nagar2021/mainet-mega/images/riel-din-arduino-mega/7150y-KmxNL._SL1500_.jpg

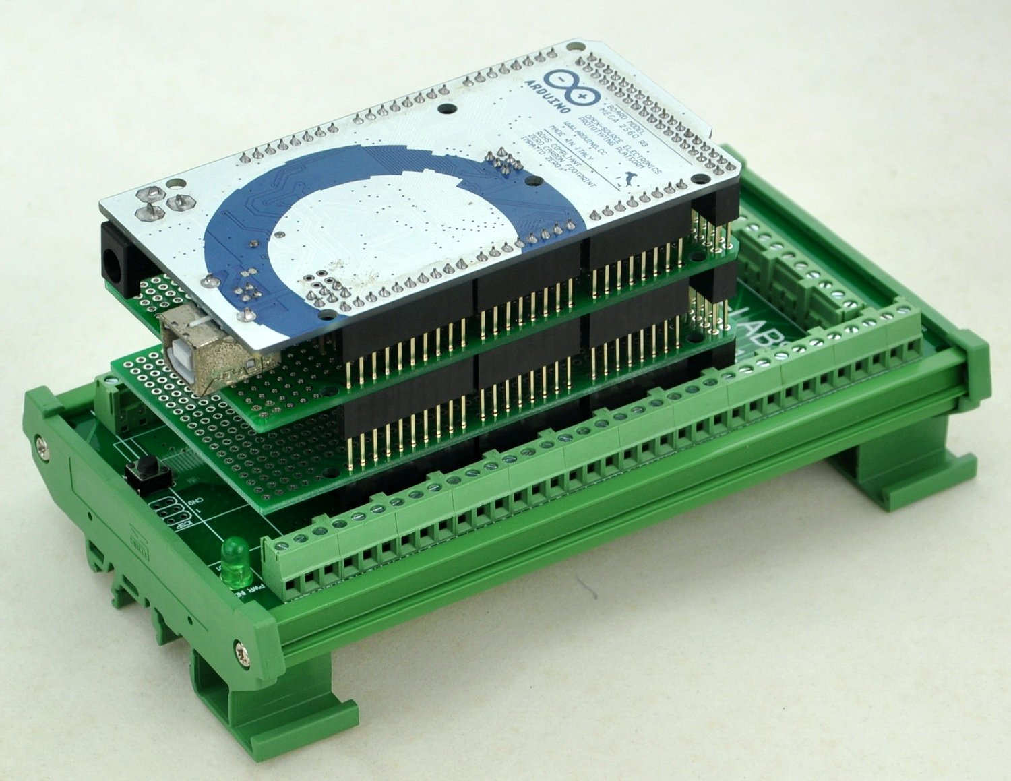
images/riel-din-arduino-mega/7150y-KmxNL._SL1500_.jpg
