nagar2021/mainet-mega/images/riel-din-arduino-mega/81a7k8UcqBL._SL1500_.jpg

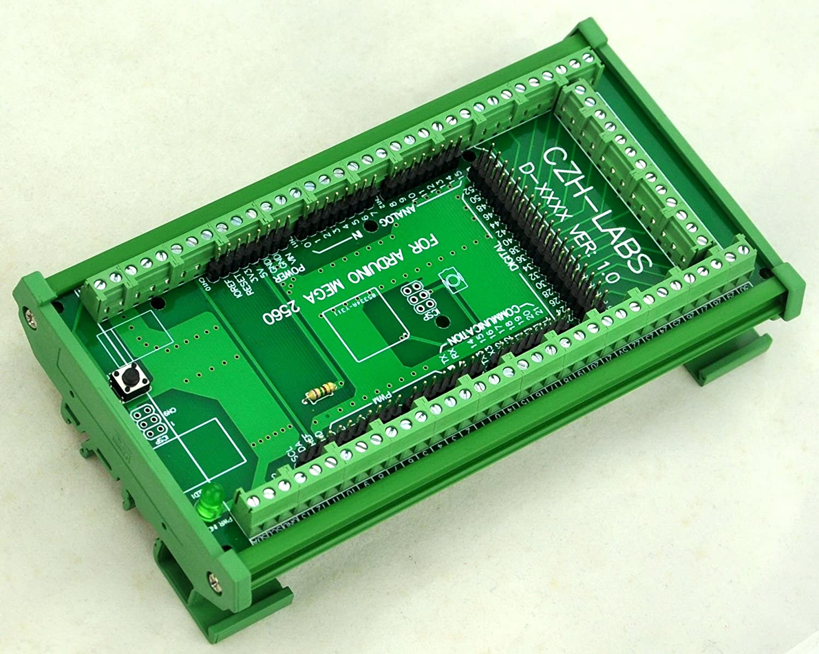
images/riel-din-arduino-mega/81a7k8UcqBL._SL1500_.jpg
