nagar2021/mainet-mega/kicad/pdf/pdf-f-silks/mainet-mega-5V-to-mp-10V--f-silk.pdf

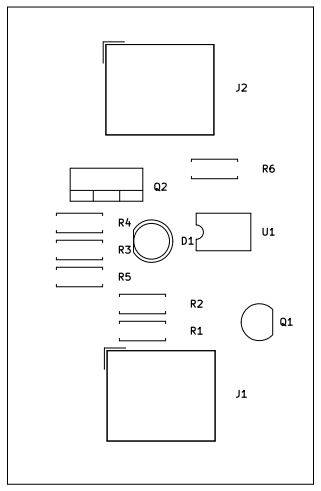
[picture p4: figure]
