nagar2021/mainet-mega/kicad/pdf/pdf-f-silks/mainet-mega-rotary-pulse-f-silk.pdf

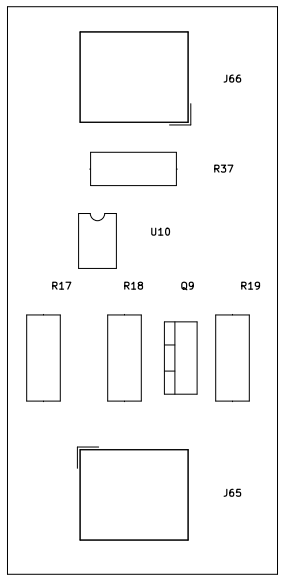
[picture p5: figure]
