nagar2021/mainet-mega/kicad/pdf/pdf-f-silks/mainet-mega-rotary-pulse-f-silk-rotado.pdf

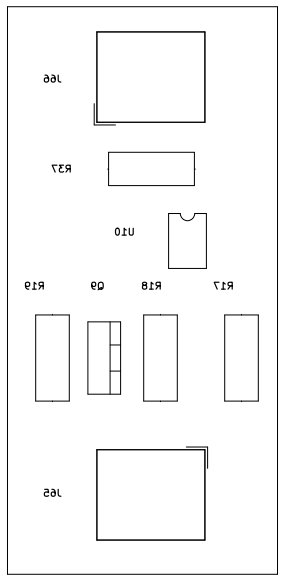
[picture p6: figure]
