nagar2021/mainet-mega/images/riel-din-arduino-mega/71Mlf5Aa4VL._SL1000_.jpg

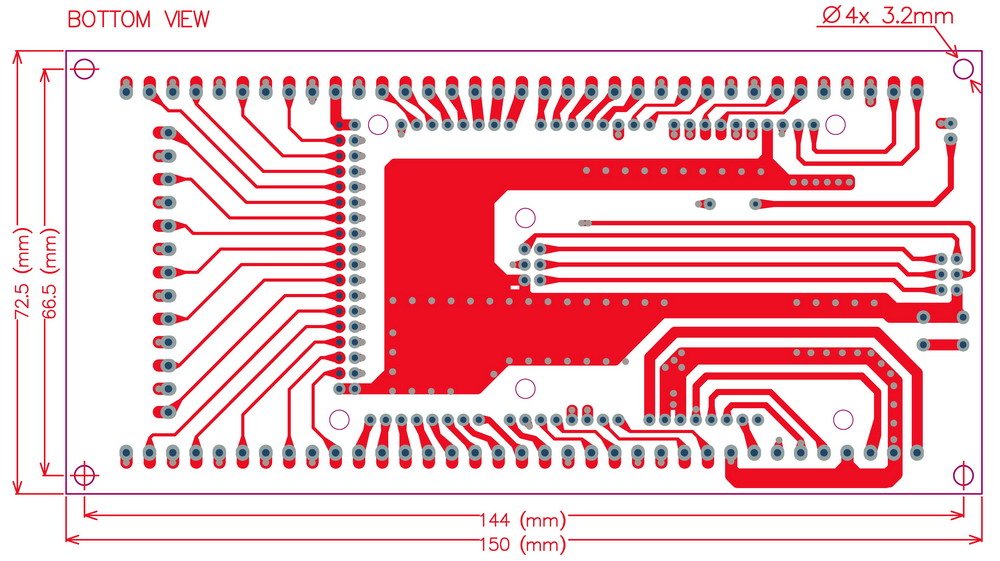
images/riel-din-arduino-mega/71Mlf5Aa4VL._SL1000_.jpg
