nagar2021/mainet-mega/images/riel-din-arduino-mega/71pCASC1ScL._SL1000_.jpg

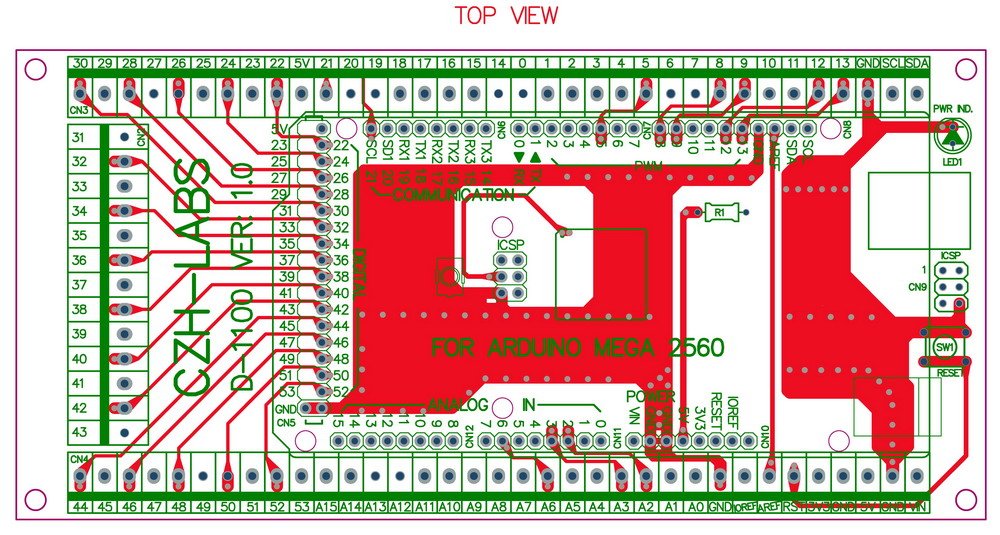
images/riel-din-arduino-mega/71pCASC1ScL._SL1000_.jpg
