nagar2021/mainet-mega/images/riel-din-arduino-mega/71uOyWxhpAL._SL1000_.jpg

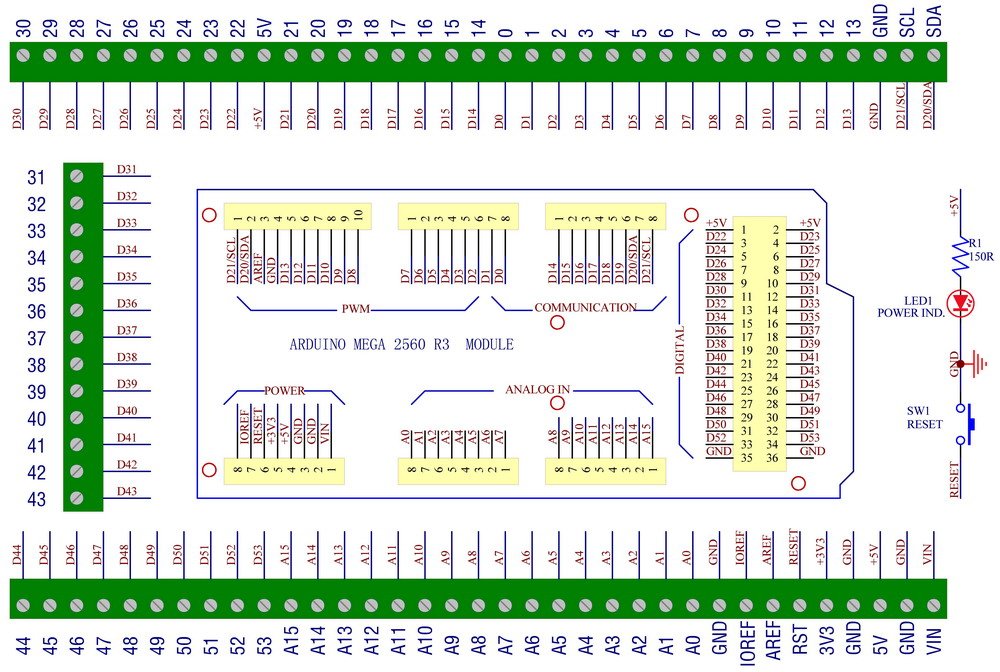
images/riel-din-arduino-mega/71uOyWxhpAL._SL1000_.jpg
