nagar2021/mainet-mega/images/riel-din-arduino-mega/81E+vQqowOL._SL1500_.jpg

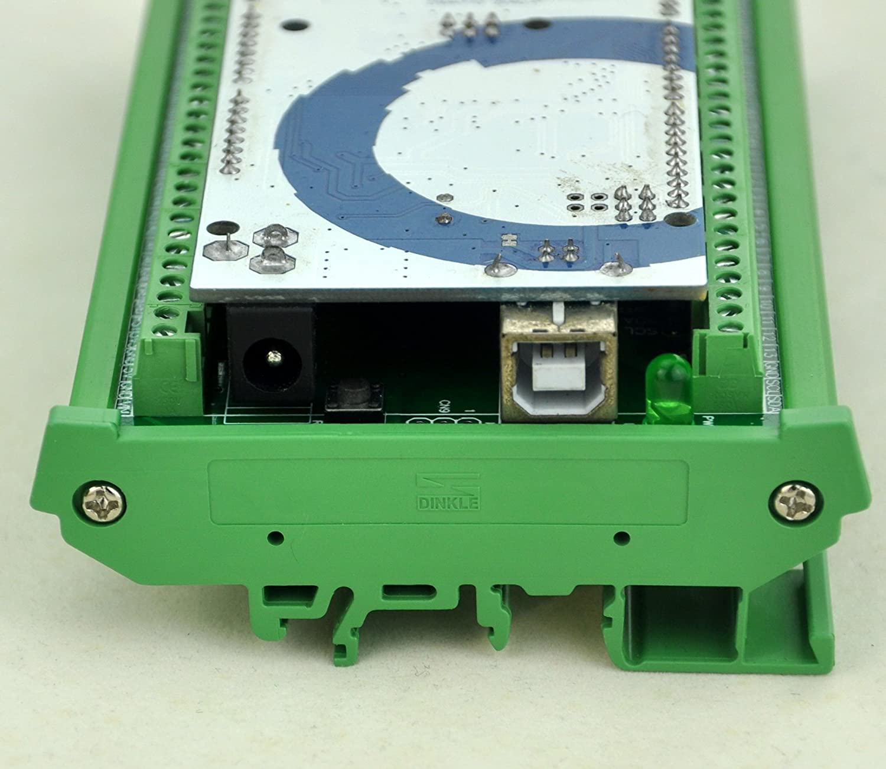
images/riel-din-arduino-mega/81E+vQqowOL._SL1500_.jpg
