nagar2021/mainet-mega/images/riel-din-arduino-mega/81m-dRdARRL._SL1500_.jpg

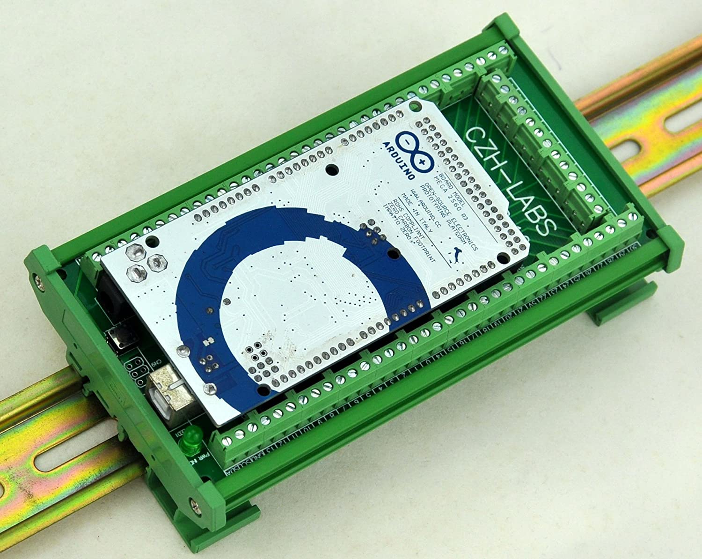
images/riel-din-arduino-mega/81m-dRdARRL._SL1500_.jpg
