nagar2021/mainet-mega/images/riel-din-arduino-mega/81qH8a+Z31L._SL1500_.jpg

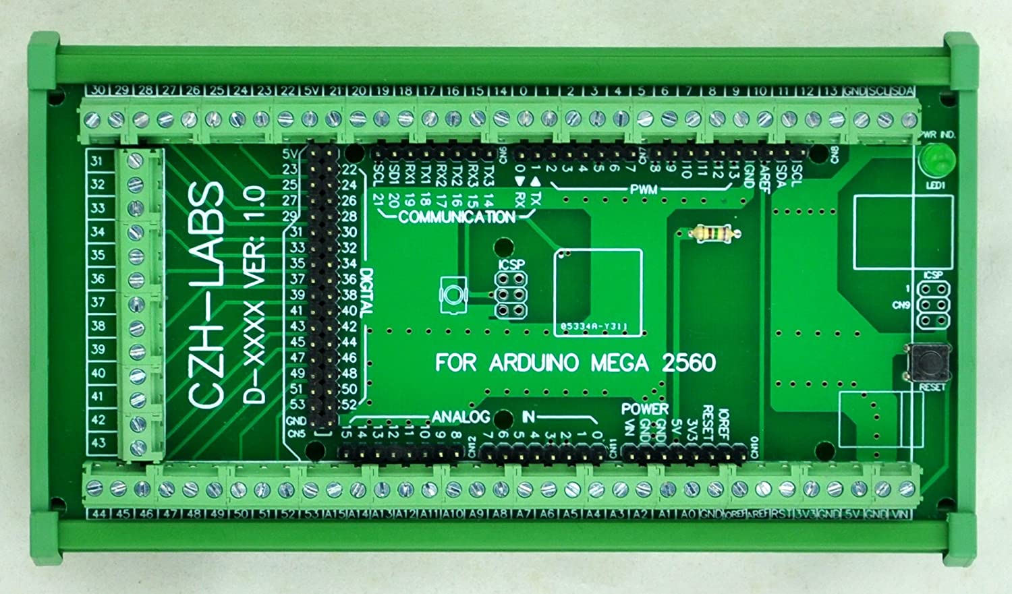
images/riel-din-arduino-mega/81qH8a+Z31L._SL1500_.jpg
