nagar2021/mainet-mega/images/riel-din-arduino-mega/8114kty3iFL._SL1500_.jpg

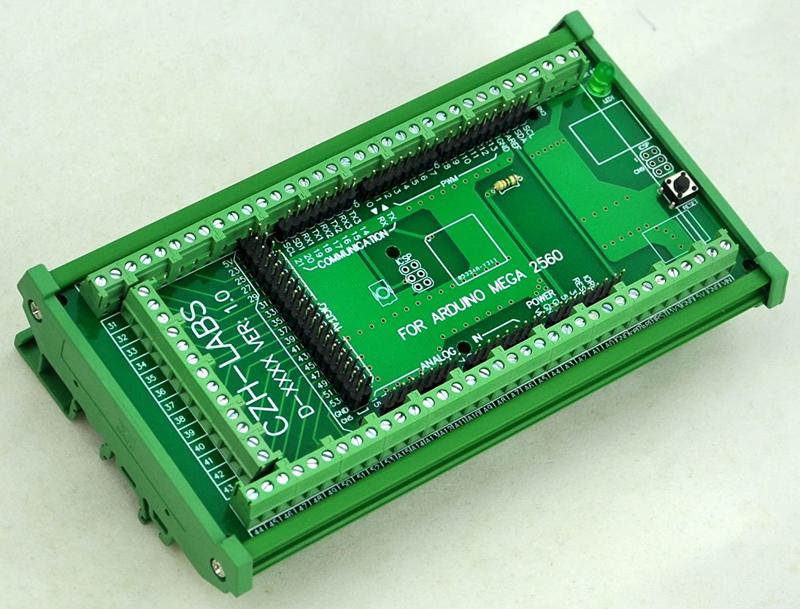
images/riel-din-arduino-mega/8114kty3iFL._SL1500_.jpg
