nagar2021/mainet-mega/images/rpg/RPG-equivalent-circuit.jpg

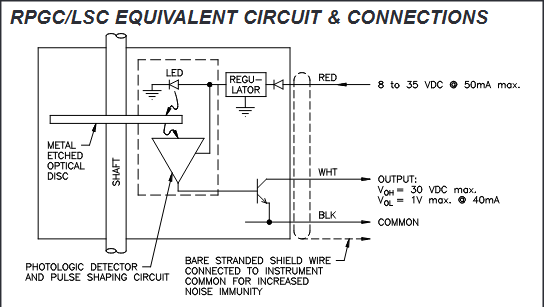
images/rpg/RPG-equivalent-circuit.jpg
