nagar2021/mainet-mega/images/rpg/RPG-frequency-output.jpg

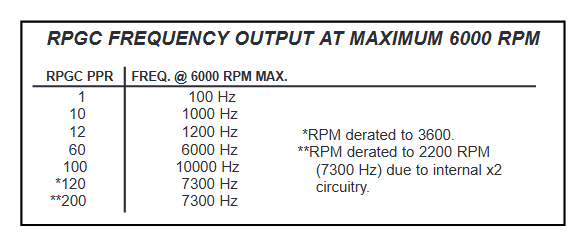
images/rpg/RPG-frequency-output.jpg
