nagar2021/mainet-mega/images/rpg/RPG-square-wave-output.jpg

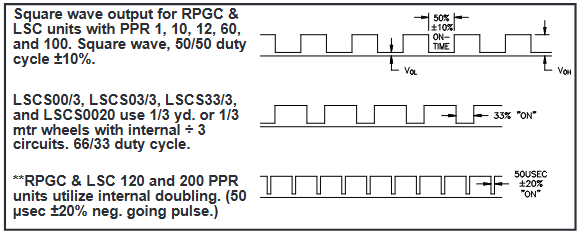
images/rpg/RPG-square-wave-output.jpg
