nagar2021/mainet-mega/images/yynmos-4/yynmos-4.jpg

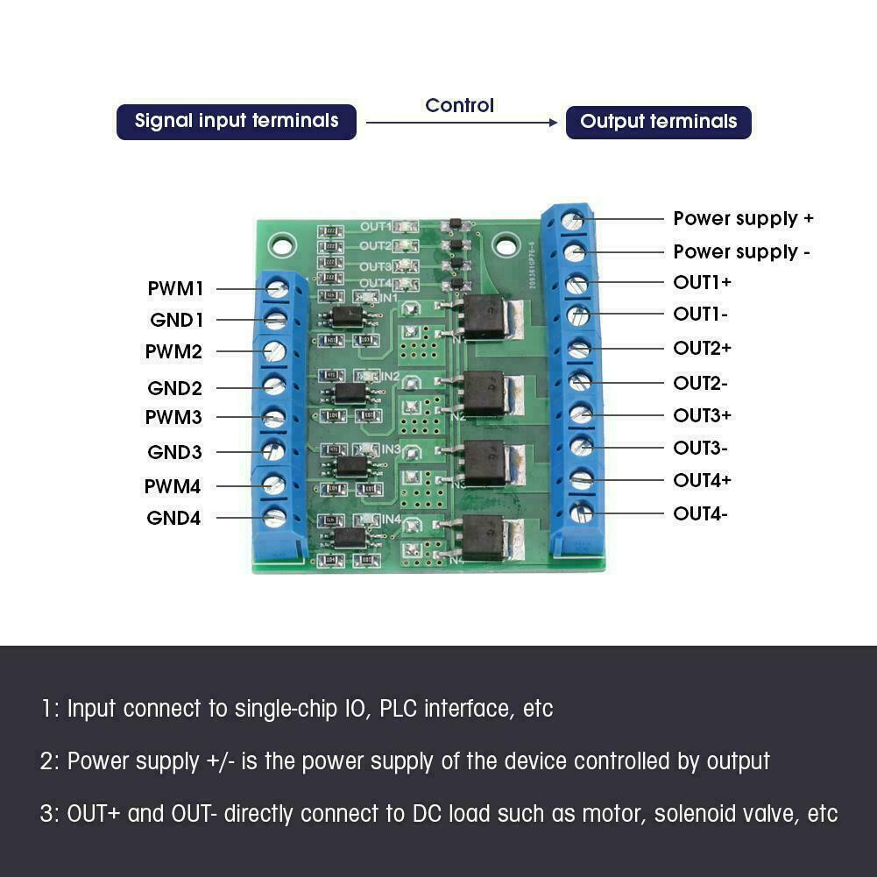
images/yynmos-4/yynmos-4.jpg
