nagar2021/mainet-mega/kicad/pdf/frequencyRefControl-mainet-mega-pwm-frequencyRefControl.pdf

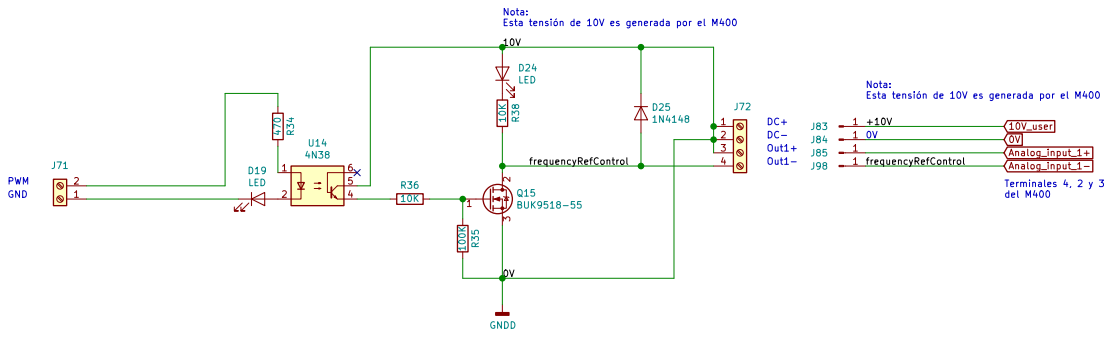
[picture p18: page 1]

0V Nota: Esta tensión de 10V es generada por el M400 GND

frequencyRefControl Nota: Esta tensión de 10V es generada por el M400

Sheet: /mainet-mega-pwm/frequencyRefControl/ Tovenca

File: frequencyRefControl.sch
Id: 18/22 Title: Mainet-mega -- frequencyRefControl
