nagar2021/mainet-mega/kicad/pdf/brakeUnwindControl-mainet-mega-pwm-brakeUnwindControl.pdf

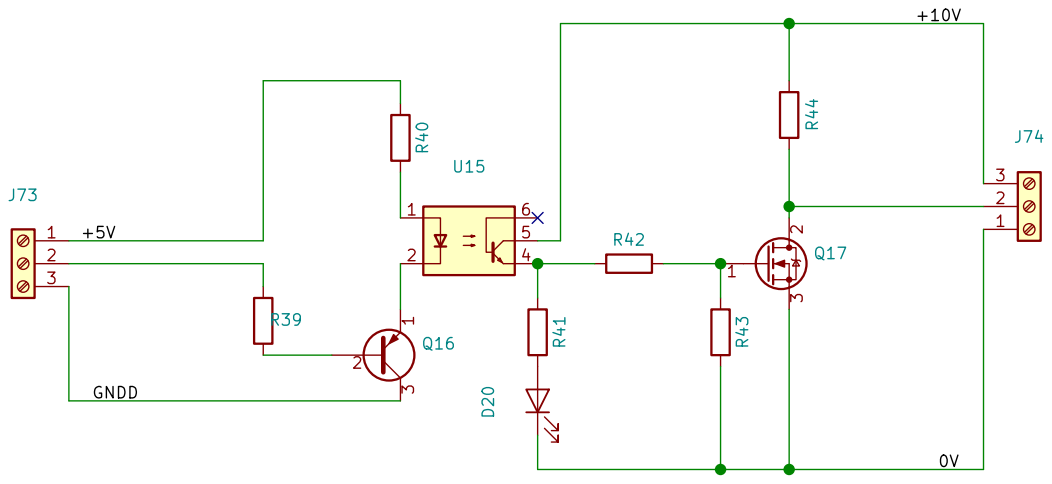
[picture p19: page 1]

Id: 19/21 Title: Mainet-mega -- brakeUnwindControl File: brakeUnwindControl.sch Sheet: /mainet-mega-pwm/brakeUnwindControl/ Tovenca R41
