nagar2021/mainet-mega/kicad/pdf/lowerClutchControl-mainet-mega-pwm-lowerClutchControl.pdf

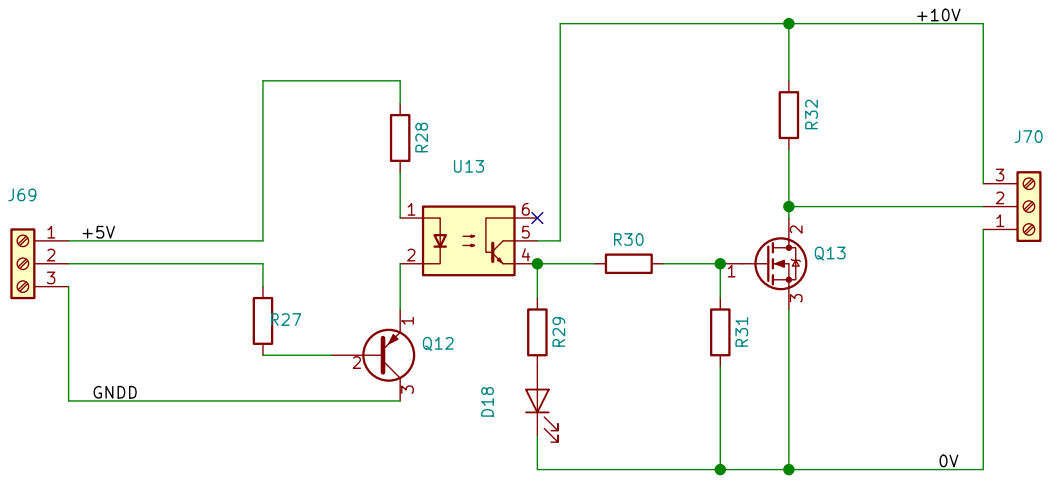
[picture p20: page 1]

Id: 17/21 Title: Mainet-mega -- lowerClutchControl File: lowerClutchControl.sch Sheet: /mainet-mega-pwm/lowerClutchControl/ Tovenca R29
