nagar2021/mainet-mega/kicad/pdf/mainet-mega-control-relay-mainet-mega-control-relay.pdf

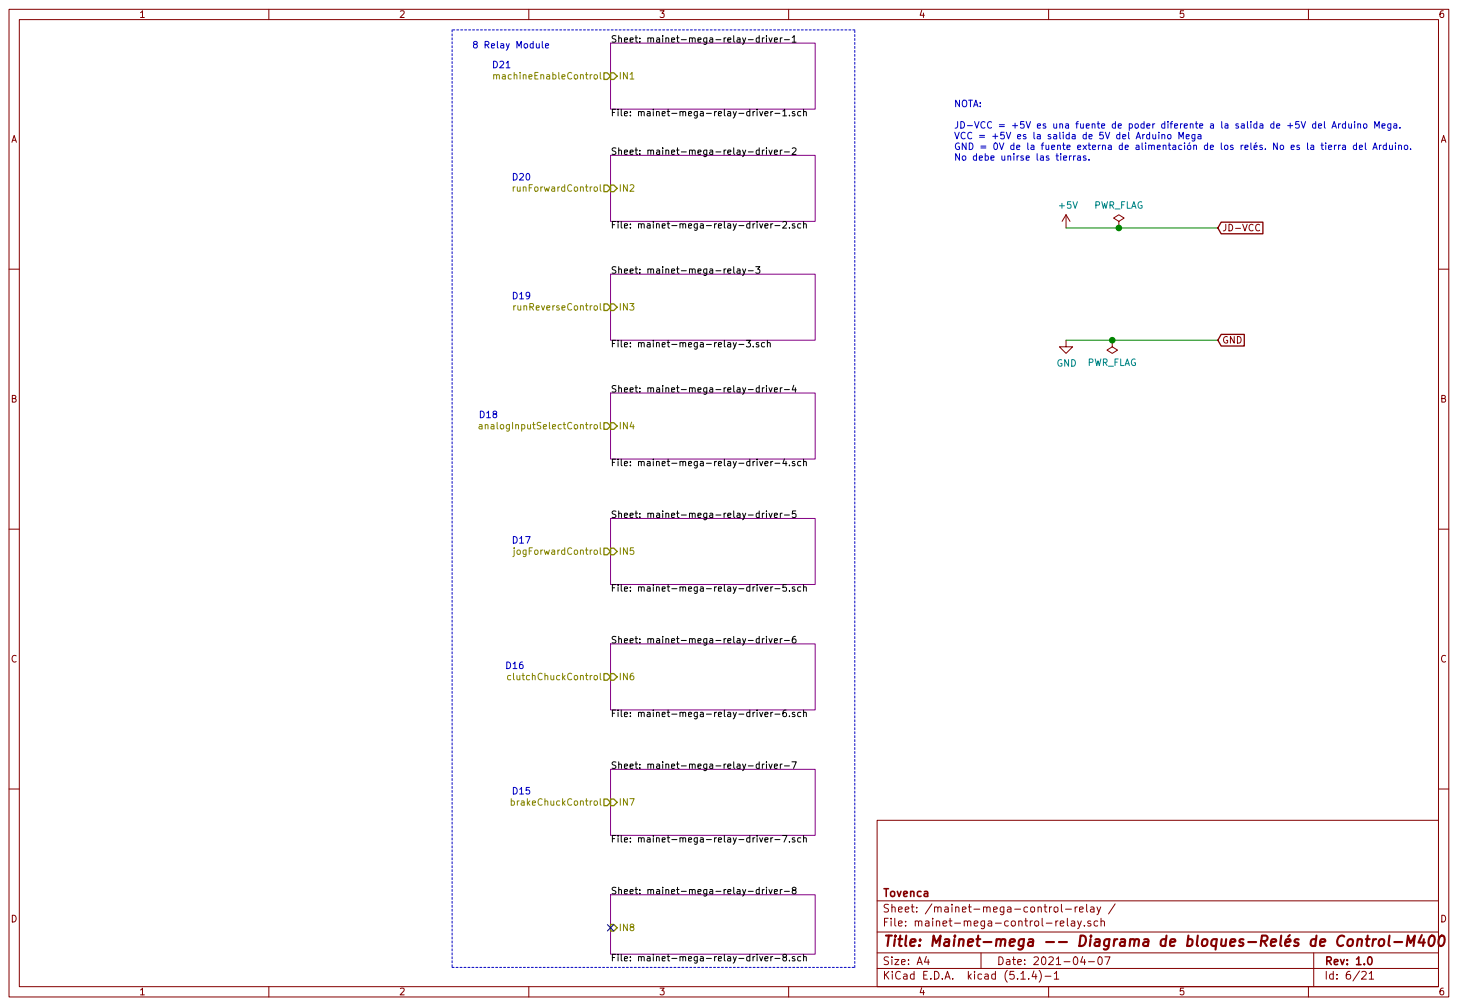
[picture p21: page 1]

Sheet: mainet-mega-relay-driver-1
runForwardControl analogInputSelectControl machineEnableControl runReverseControl

VCC = +5V es la salida de 5V del Arduino Mega GND = 0V de la fuente externa de alimentación de los relés. No es la tierra del Arduino. No debe unirse las tierras. 8 Relay Module D16

File: mainet-mega-relay-driver-1.sch

NOTA: JD-VCC = +5V es una fuente de poder diferente a la salida de +5V del Arduino Mega.

Sheet: mainet-mega-relay-driver-2

IN2 Sheet: mainet-mega-relay-3

File: mainet-mega-relay-driver-2.sch

IN3 Sheet: mainet-mega-relay-driver-4

File: mainet-mega-relay-3.sch

IN4 Sheet: mainet-mega-relay-driver-5

File: mainet-mega-relay-driver-4.sch

IN5 Sheet: mainet-mega-relay-driver-6

File: mainet-mega-relay-driver-5.sch

IN6 Sheet: mainet-mega-relay-driver-7

File: mainet-mega-relay-driver-6.sch

IN7 Sheet: mainet-mega-relay-driver-8

File: mainet-mega-relay-driver-7.sch

Sheet: /mainet-mega-control-relay / Tovenca

File: mainet-mega-control-relay.sch
Id: 6/21 Title: Mainet-mega -- Diagrama de bloques-Relés de Control-M400

File: mainet-mega-relay-driver-8.sch
