nagar2021/mainet-mega/kicad/pdf/mainet-mega-pwm-mainet-mega-pwm.pdf

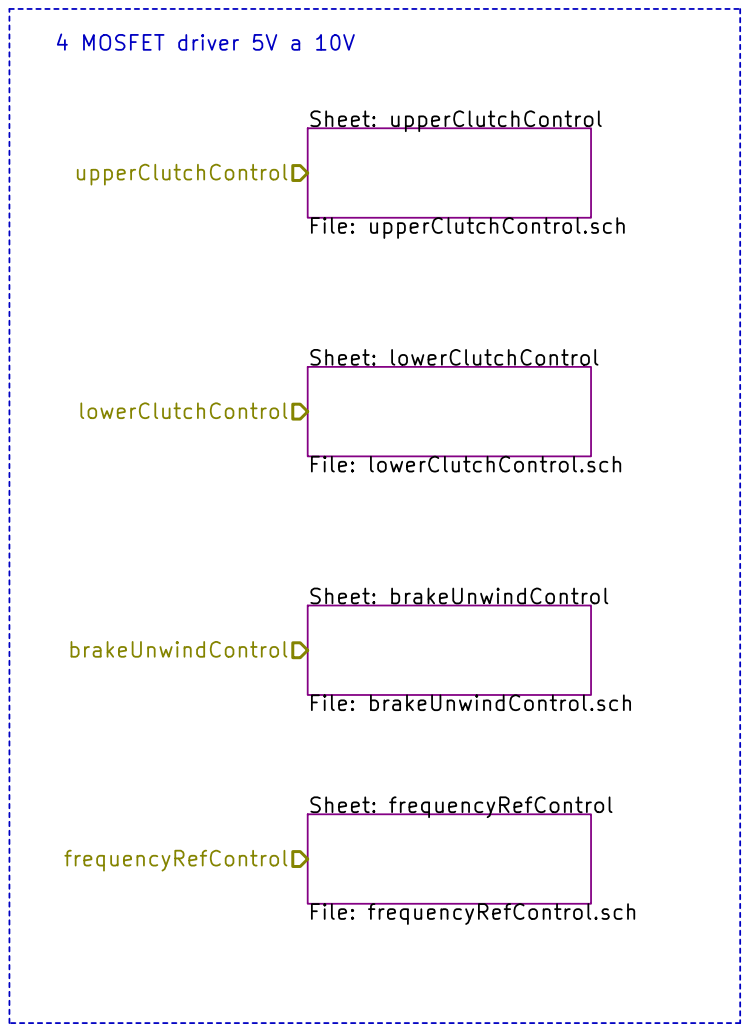
[picture p22: page 1]

4 MOSFET driver 5V a 10V
File: upperClutchControl.sch Sheet: lowerClutchControl File: lowerClutchControl.sch Sheet: frequencyRefControl

File: frequencyRefControl.sch Sheet: brakeUnwindControl File: brakeUnwindControl.sch

Sheet: /mainet-mega-pwm/ Tovenca

File: mainet-mega-pwm.sch
Id: 15/21 Title: Mainet-mega -- Convertidores de Voltaje: 5V a 10V
