nagar2021/mainet-mega/kicad/pdf/mainet-mega-relay-3-mainet-mega-control-relay -mainet-mega-relay-3.pdf

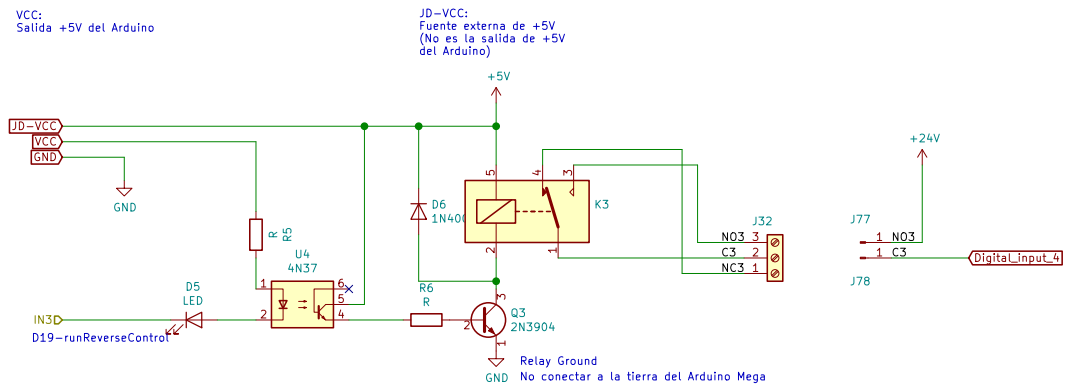
[picture p23: page 1]

JD-VCC: Fuente externa de +5V

(No es la salida de +5V

Sheet: /mainet-mega-control-relay /mainet-mega-relay-3/ Tovenca D5
LED

File: mainet-mega-relay-3.sch
Id: 9/21 Title: Mainet-mega -- runReverseControl
