nagar2021/mainet-mega/kicad/pdf/mainet-mega-relay-driver-1--7.pdf

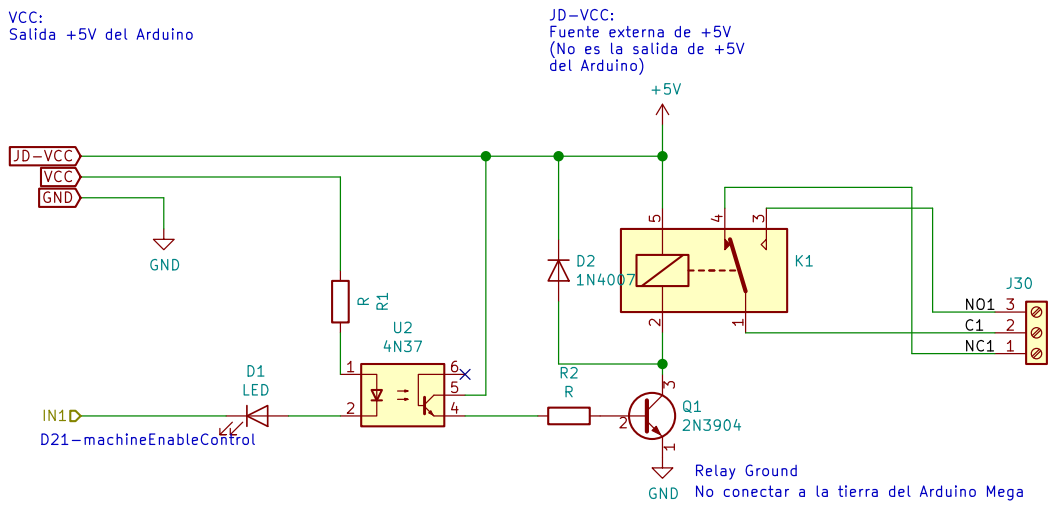
[picture p24: page 1]

JD-VCC: Fuente externa de +5V

(No es la salida de +5V
del Arduino)

Sheet: /mainet-mega-control-relay /mainet-mega-relay-driver-1/ Tovenca R2R

File: mainet-mega-relay-driver-1.sch
Id: 7/21 Title: Mainet-mega -- machineEnableControl
