nagar2021/mainet-mega/kicad/pdf/mainet-mega-relay-driver-2--8.pdf

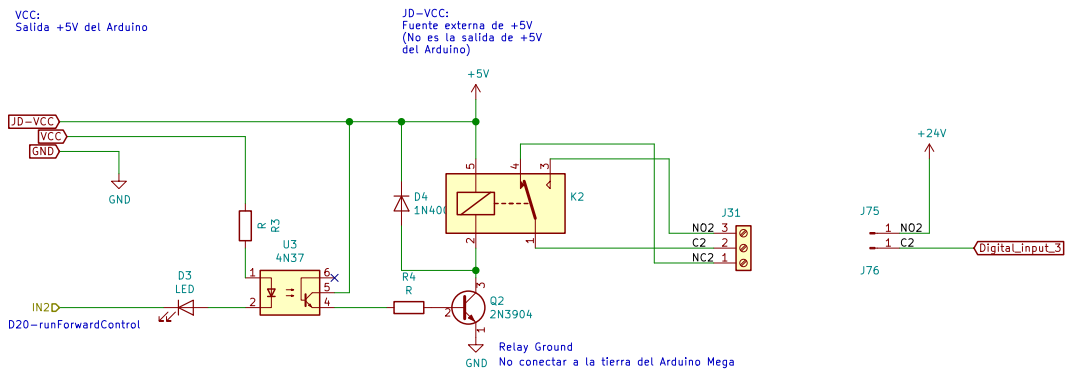
[picture p25: page 1]

(No es la salida de +5V

Sheet: /mainet-mega-control-relay /mainet-mega-relay-driver-2/ Tovenca D3
LED

File: mainet-mega-relay-driver-2.sch
Id: 8/21 Title: Mainet-mega -- runForwardControl
