nagar2021/mainet-mega/kicad/pdf/mainet-mega-relay-driver-4--10.pdf

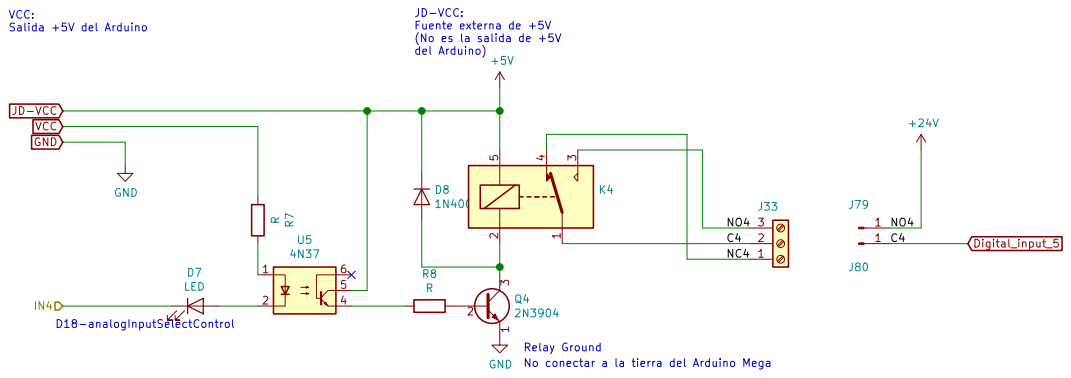
[picture p26: page 1]

del Arduino) VCC: Salida +5V del Arduino D18-analogInputSelectControl

JD-VCC: Fuente externa de +5V

(No es la salida de +5V

Sheet: /mainet-mega-control-relay /mainet-mega-relay-driver-4/ Tovenca D7
LED

File: mainet-mega-relay-driver-4.sch
Id: 10/21 Title: Mainet-mega -- analogInputSelectControl
