nagar2021/mainet-mega/kicad/pdf/mainet-mega-relay-driver-5--11.pdf

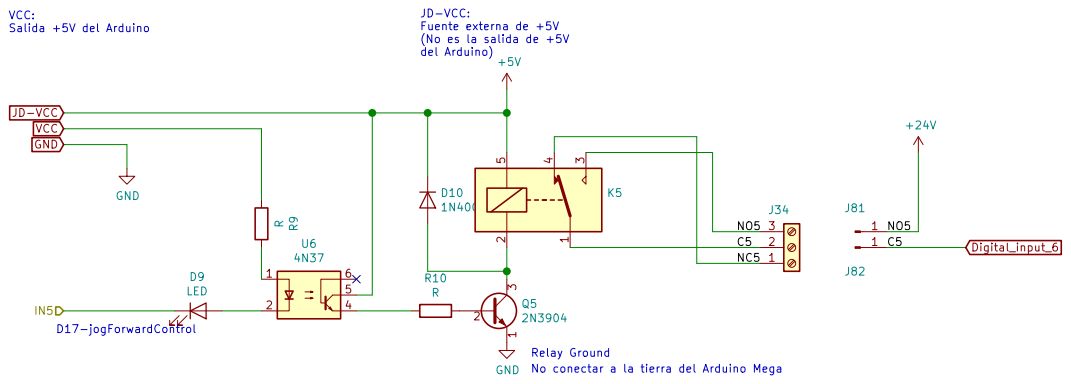
[picture p27: page 1]

del Arduino) VCC: Salida +5V del Arduino D17-jogForwardControl

JD-VCC: Fuente externa de +5V

(No es la salida de +5V

Sheet: /mainet-mega-control-relay /mainet-mega-relay-driver-5/ Tovenca R10 R

File: mainet-mega-relay-driver-5.sch
Id: 11/21 Title: Mainet-mega --
