nagar2021/mainet-mega/kicad/pdf/mainet-mega-relay-driver-6--12.pdf

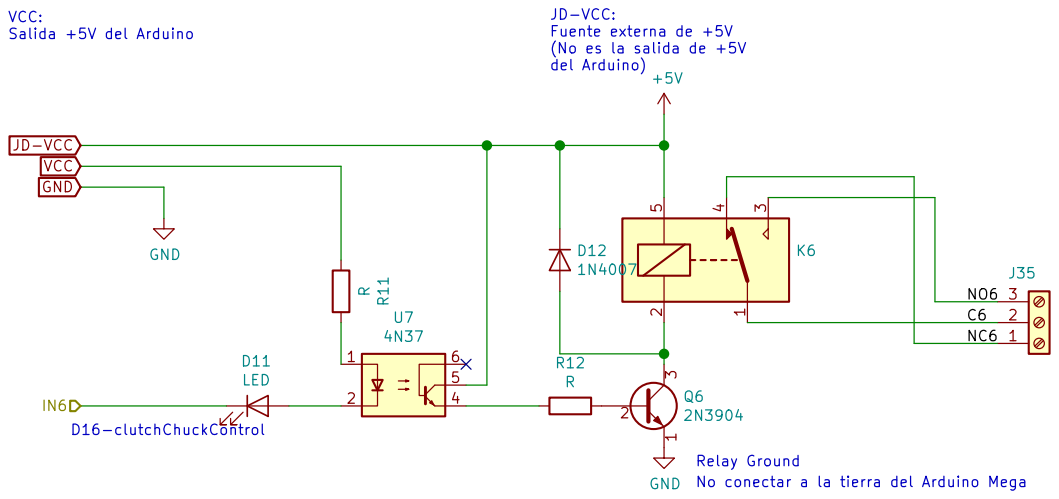
[picture p28: page 1]

JD-VCC: Fuente externa de +5V

(No es la salida de +5V

Sheet: /mainet-mega-control-relay /mainet-mega-relay-driver-6/ Tovenca R12 R

File: mainet-mega-relay-driver-6.sch
Id: 12/21 Title: Mainet-mega -- clutchChunkControl
