nagar2021/mainet-mega/kicad/pdf/mainet-mega-relay-driver-7--13.pdf

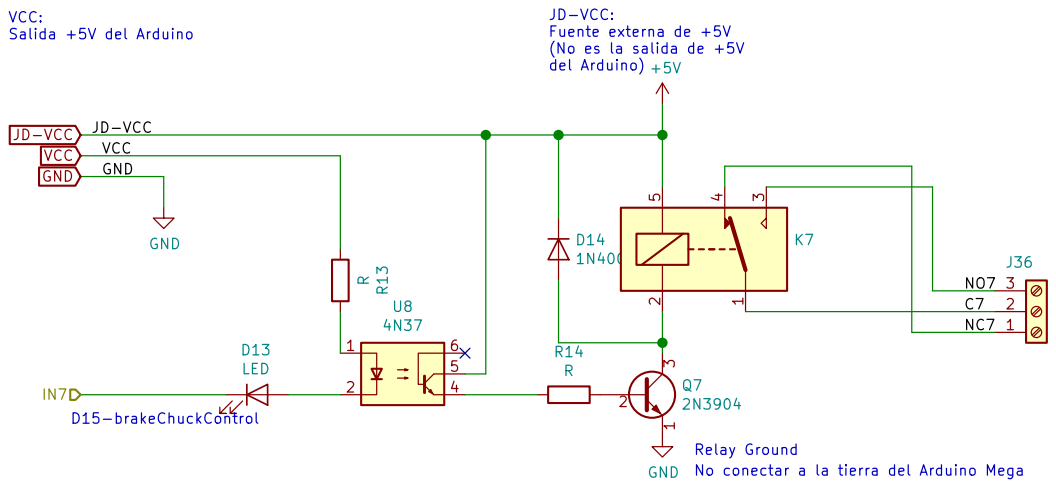
[picture p29: page 1]

JD-VCC: Fuente externa de +5V

(No es la salida de +5V

File: mainet-mega-relay-driver-7.sch
Id: 13/21 Title: Mainet-mega -- brakeChunkControl
