nagar2021/mainet-mega/kicad/pdf/mainet-mega-relay-driver-8--14.pdf

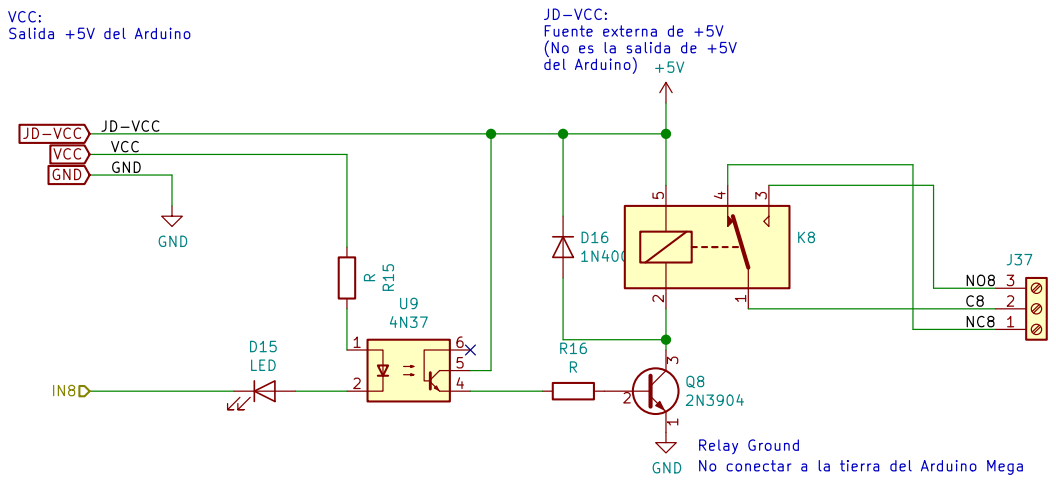
[picture p30: page 1]

JD-VCC: Fuente externa de +5V

(No es la salida de +5V

File: mainet-mega-relay-driver-8.sch
Id: 14/21 Title: Mainet-mega --
