nagar2021/mainet-mega/kicad/pdf/mainet-mega-rotary-pulse-mainet-mega-rotary-pulse.pdf

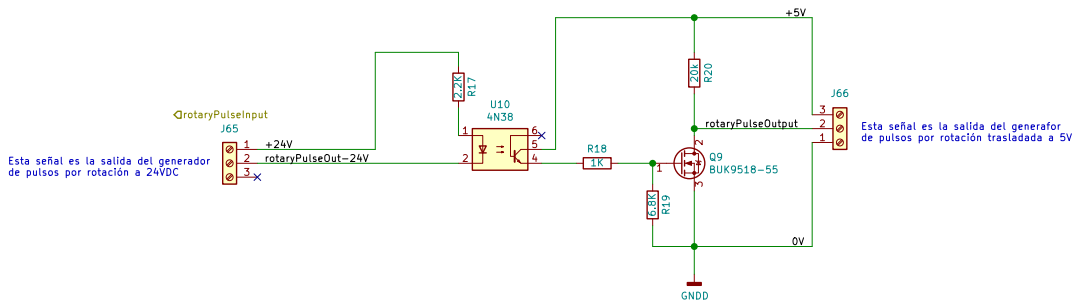
[picture p31: page 1]

Esta señal es la salida del generafor
de pulsos por rotación trasladada a 5V

Esta señal es la salida del generador
de pulsos por rotación a 24VDC

Sheet: /mainet-mega-rotary-pulse/ Tovenca

File: mainet-mega-rotary-pulse.sch
Id: 21/21 Title: Mainet-mega -- Convertidor de Voltaje: 24V a 5V
