nagar2021/mainet-mega/kicad/pdf/mainet-mega.pdf

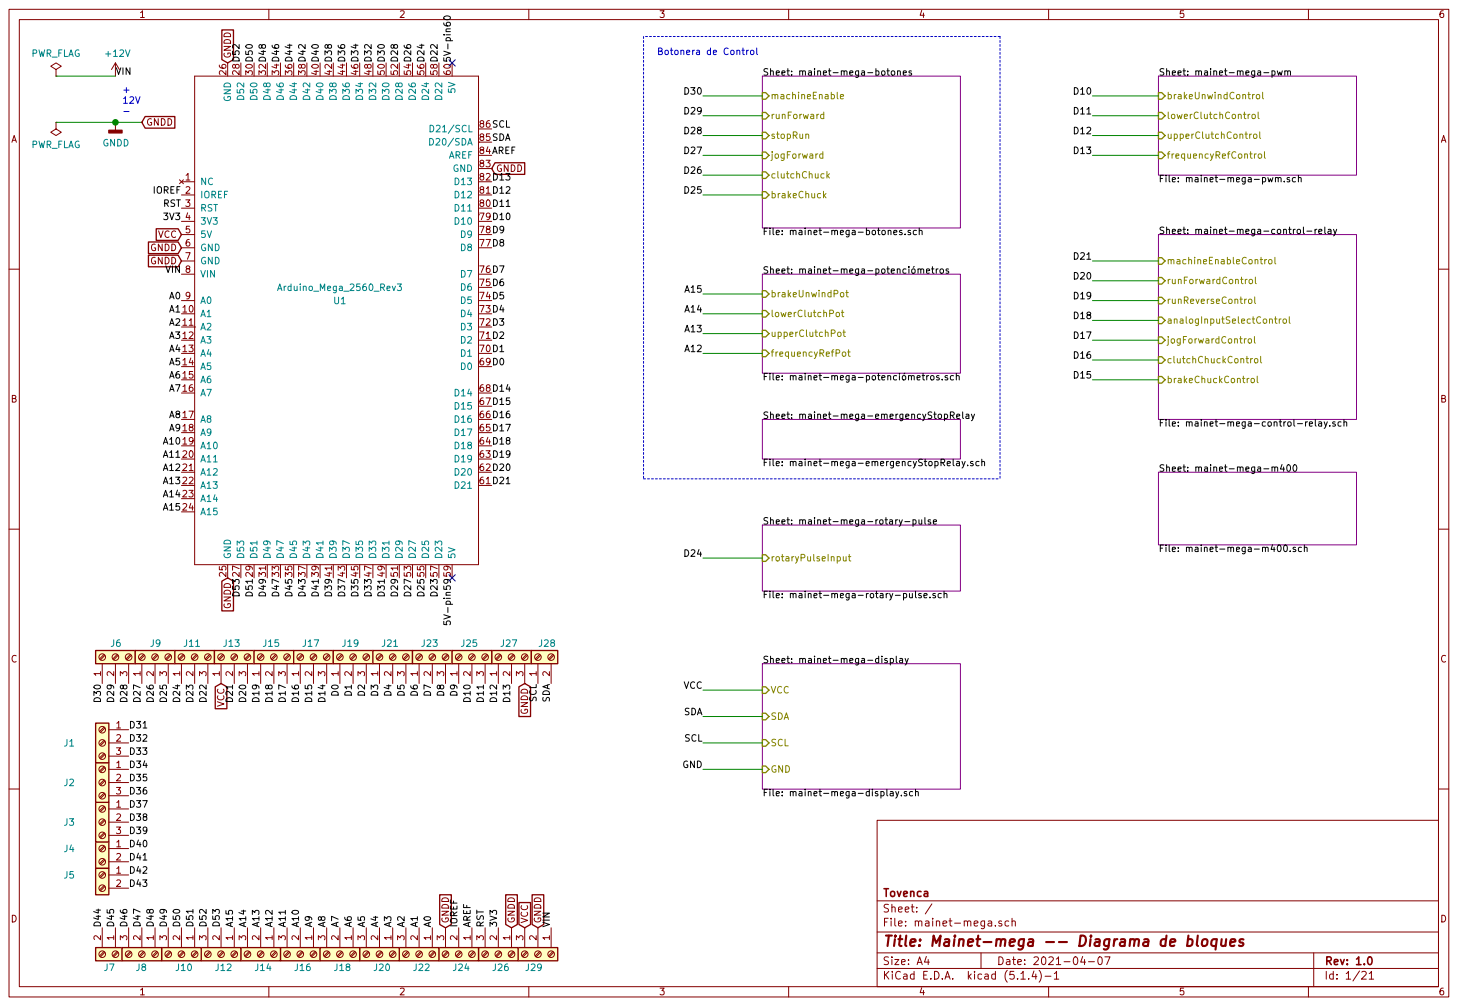
[picture p32: page 1]

Sheet: mainet-mega-botones

jogForwardControl clutchChuckControl brakeChuckControl Sheet: mainet-mega-pwm

clutchChuck brakeChuck Sheet: mainet-mega-potenciómetros

File: mainet-mega-pwm.sch

File: mainet-mega-botones.sch

Sheet: mainet-mega-control-relay

analogInputSelectControl runForwardControl runReverseControl machineEnableControl

File: mainet-mega-potenciómetros.sch

Sheet: mainet-mega-emergencyStopRelay

File: mainet-mega-control-relay.sch

File: mainet-mega-emergencyStopRelay.sch

File: mainet-mega.sch Sheet: / Tovenca Sheet: mainet-mega-rotary-pulse

File: mainet-mega-m400.sch

File: mainet-mega-rotary-pulse.sch

Sheet: mainet-mega-display

File: mainet-mega-display.sch VCC

Id: 1/21 Title: Mainet-mega -- Diagrama de bloques

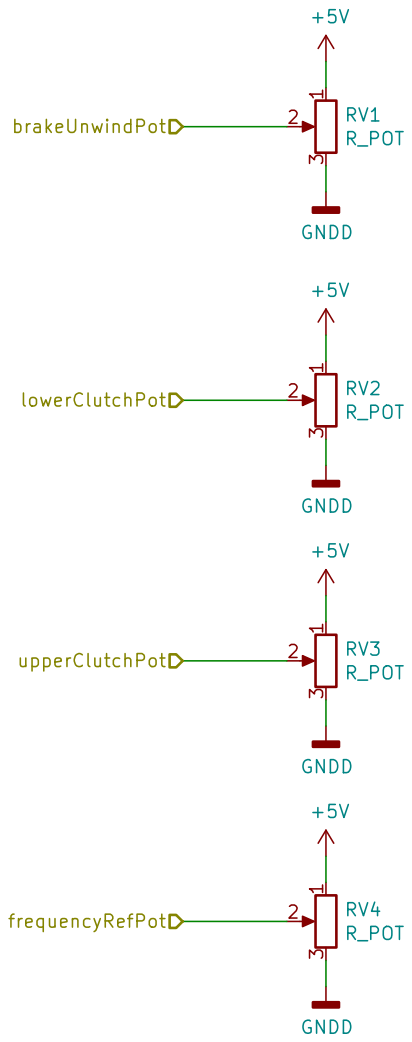
[picture p33: page 2]

Sheet: /mainet-mega-potenciómetros/ Tovenca

File: mainet-mega-potenciómetros.sch
Id: 2/21 Title: Mainet-mega -- Potenciómetros de Control

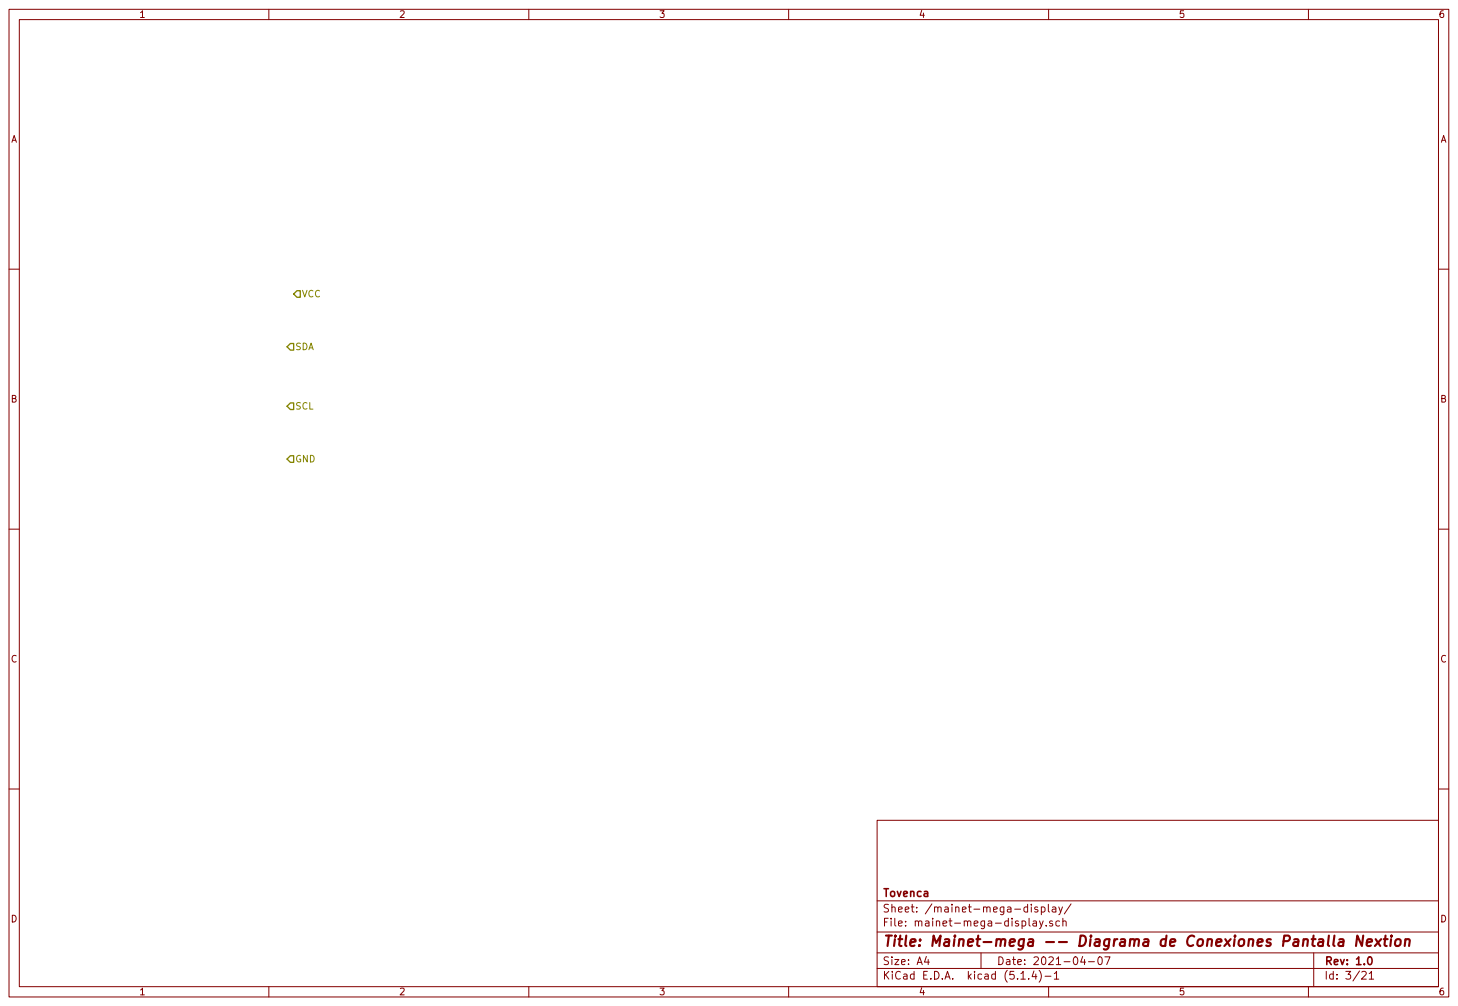
[picture p34: page 3]

Sheet: /mainet-mega-display/ Tovenca

File: mainet-mega-display.sch
Id: 3/21 Title: Mainet-mega -- Diagrama de Conexiones Pantalla Nextion

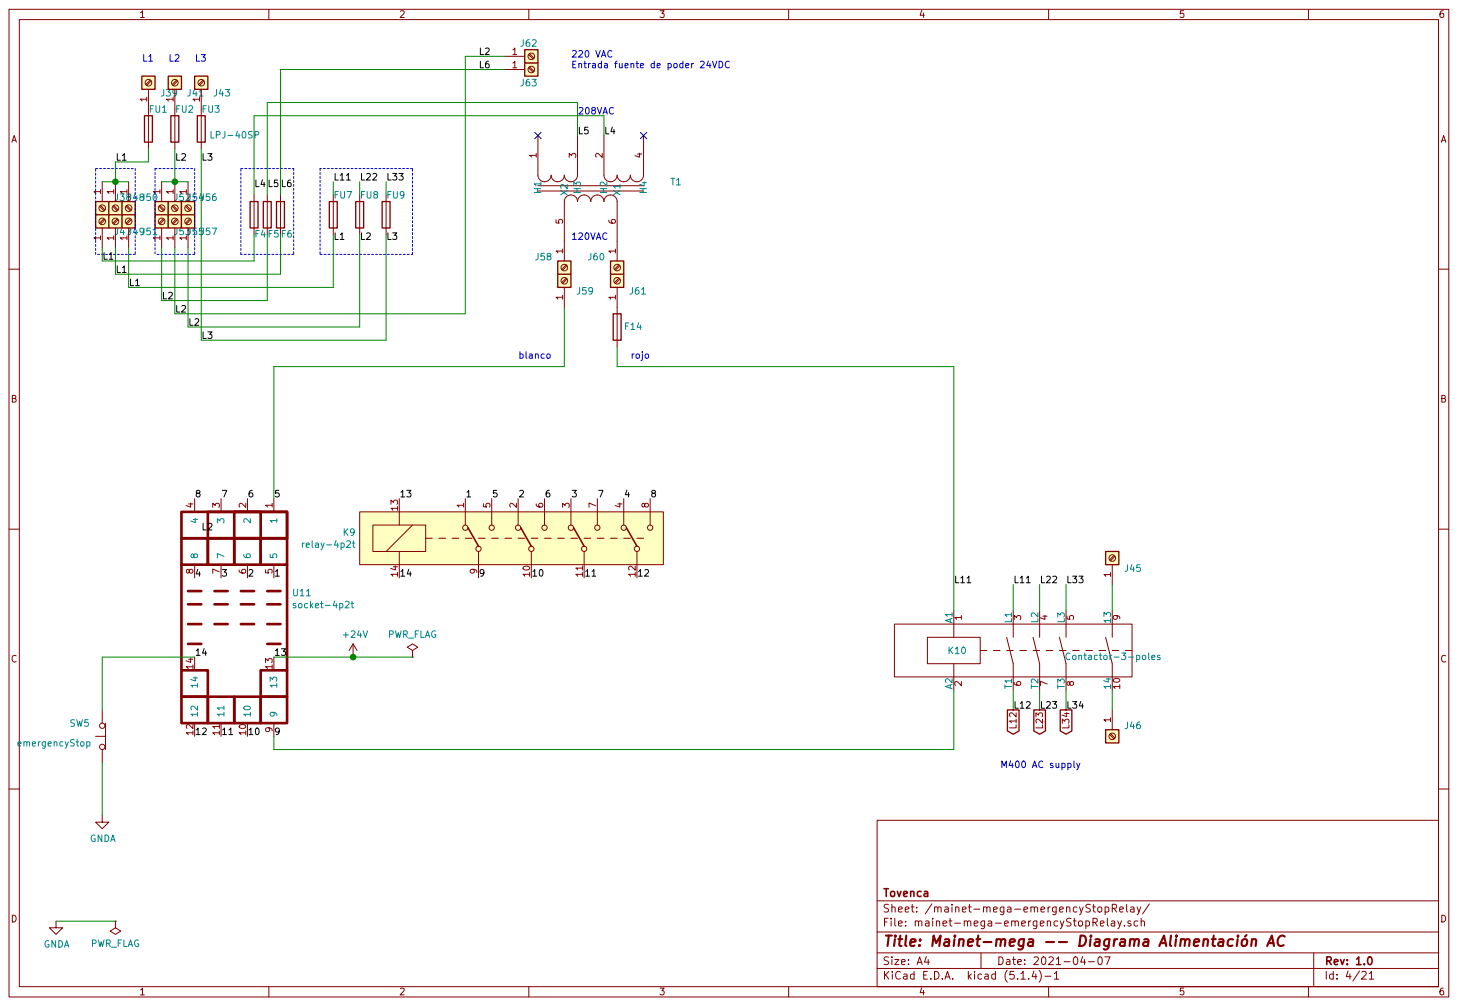
[picture p35: page 4]

L1

L2

Sheet: /mainet-mega-emergencyStopRelay/ Tovenca

File: mainet-mega-emergencyStopRelay.sch
Id: 4/21 Title: Mainet-mega -- Diagrama Alimentación AC

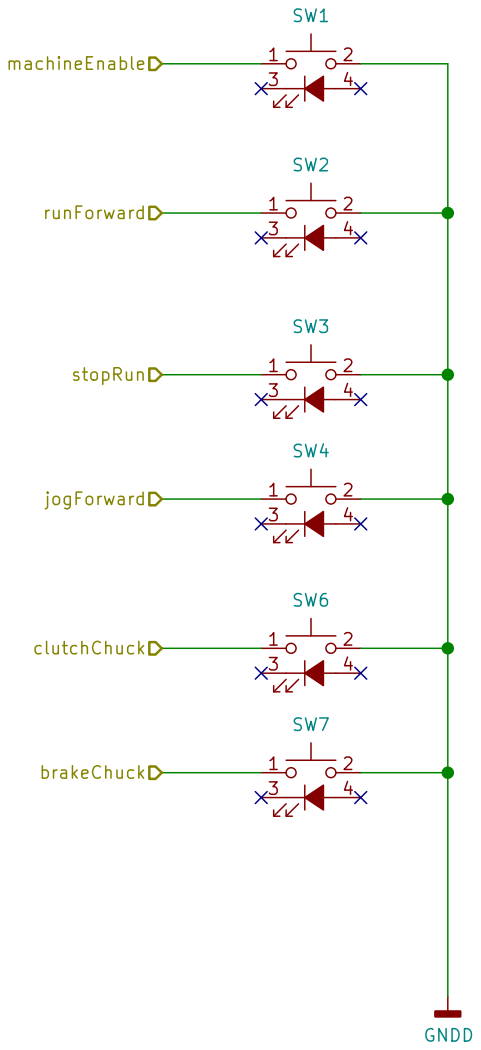
[picture p36: page 5]

Sheet: /mainet-mega-botones/ Tovenca

File: mainet-mega-botones.sch
Id: 5/21 Title: Mainet-mega -- Botonera de Control


Sheet: mainet-mega-relay-driver-1
runForwardControl analogInputSelectControl machineEnableControl runReverseControl

VCC = +5V es la salida de 5V del Arduino Mega GND = 0V de la fuente externa de alimentación de los relés. No es la tierra del Arduino. No debe unirse las tierras. 8 Relay Module D16

File: mainet-mega-relay-driver-1.sch

NOTA: JD-VCC = +5V es una fuente de poder diferente a la salida de +5V del Arduino Mega.

Sheet: mainet-mega-relay-driver-2

IN2 Sheet: mainet-mega-relay-3

File: mainet-mega-relay-driver-2.sch

IN3 Sheet: mainet-mega-relay-driver-4

File: mainet-mega-relay-3.sch

IN4 Sheet: mainet-mega-relay-driver-5

File: mainet-mega-relay-driver-4.sch

IN5 Sheet: mainet-mega-relay-driver-6

File: mainet-mega-relay-driver-5.sch

IN6 Sheet: mainet-mega-relay-driver-7

File: mainet-mega-relay-driver-6.sch

IN7 Sheet: mainet-mega-relay-driver-8

File: mainet-mega-relay-driver-7.sch

Sheet: /mainet-mega-control-relay / Tovenca

File: mainet-mega-control-relay.sch
Id: 6/21 Title: Mainet-mega -- Diagrama de bloques-Relés de Control-M400

File: mainet-mega-relay-driver-8.sch


JD-VCC: Fuente externa de +5V

(No es la salida de +5V
del Arduino)

Sheet: /mainet-mega-control-relay /mainet-mega-relay-driver-1/ Tovenca R2R

File: mainet-mega-relay-driver-1.sch
Id: 7/21 Title: Mainet-mega -- machineEnableControl


(No es la salida de +5V

Sheet: /mainet-mega-control-relay /mainet-mega-relay-driver-2/ Tovenca D3
LED

File: mainet-mega-relay-driver-2.sch
Id: 8/21 Title: Mainet-mega -- runForwardControl


JD-VCC: Fuente externa de +5V

(No es la salida de +5V

Sheet: /mainet-mega-control-relay /mainet-mega-relay-3/ Tovenca D5
LED

File: mainet-mega-relay-3.sch
Id: 9/21 Title: Mainet-mega -- runReverseControl


del Arduino) VCC: Salida +5V del Arduino D18-analogInputSelectControl

JD-VCC: Fuente externa de +5V

(No es la salida de +5V

Sheet: /mainet-mega-control-relay /mainet-mega-relay-driver-4/ Tovenca D7
LED

File: mainet-mega-relay-driver-4.sch
Id: 10/21 Title: Mainet-mega -- analogInputSelectControl


del Arduino) VCC: Salida +5V del Arduino D17-jogForwardControl

JD-VCC: Fuente externa de +5V

(No es la salida de +5V

Sheet: /mainet-mega-control-relay /mainet-mega-relay-driver-5/ Tovenca R10 R

File: mainet-mega-relay-driver-5.sch
Id: 11/21 Title: Mainet-mega --


JD-VCC: Fuente externa de +5V

(No es la salida de +5V

Sheet: /mainet-mega-control-relay /mainet-mega-relay-driver-6/ Tovenca R12 R

File: mainet-mega-relay-driver-6.sch
Id: 12/21 Title: Mainet-mega -- clutchChunkControl


JD-VCC: Fuente externa de +5V

(No es la salida de +5V

File: mainet-mega-relay-driver-7.sch
Id: 13/21 Title: Mainet-mega -- brakeChunkControl


JD-VCC: Fuente externa de +5V

(No es la salida de +5V

File: mainet-mega-relay-driver-8.sch
Id: 14/21 Title: Mainet-mega --


4 MOSFET driver 5V a 10V
File: upperClutchControl.sch Sheet: lowerClutchControl File: lowerClutchControl.sch Sheet: frequencyRefControl

File: frequencyRefControl.sch Sheet: brakeUnwindControl File: brakeUnwindControl.sch

Sheet: /mainet-mega-pwm/ Tovenca

File: mainet-mega-pwm.sch
Id: 15/21 Title: Mainet-mega -- Convertidores de Voltaje: 5V a 10V

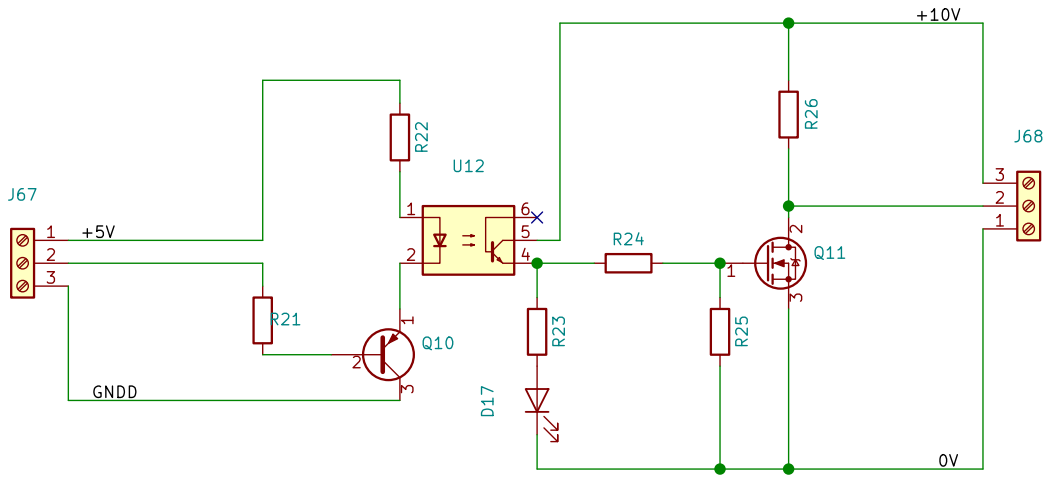
[picture p37: page 16]

Sheet: /mainet-mega-pwm/upperClutchControl/ Tovenca R23

File: upperClutchControl.sch
Id: 16/21 Title: Mainet-mega -- upperClutchControl


Id: 17/21 Title: Mainet-mega -- lowerClutchControl File: lowerClutchControl.sch Sheet: /mainet-mega-pwm/lowerClutchControl/ Tovenca R29

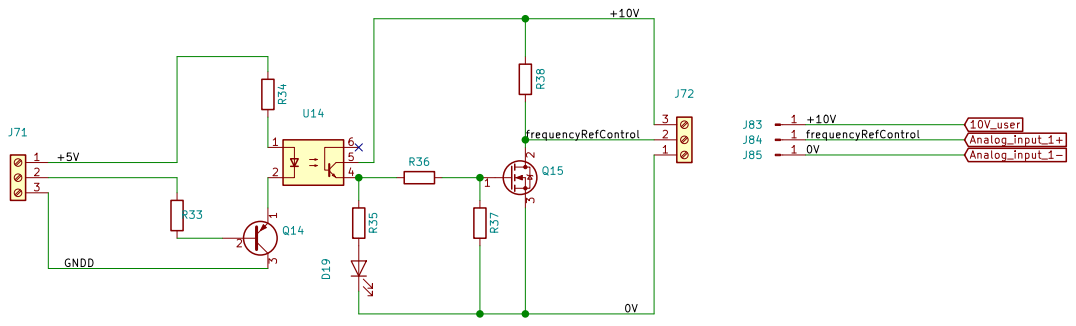
[picture p38: page 18]

Sheet: /mainet-mega-pwm/frequencyRefControl/ Tovenca

File: frequencyRefControl.sch
Id: 18/21 Title: Mainet-mega -- frequencyRefControl


Id: 19/21 Title: Mainet-mega -- brakeUnwindControl File: brakeUnwindControl.sch Sheet: /mainet-mega-pwm/brakeUnwindControl/ Tovenca R41

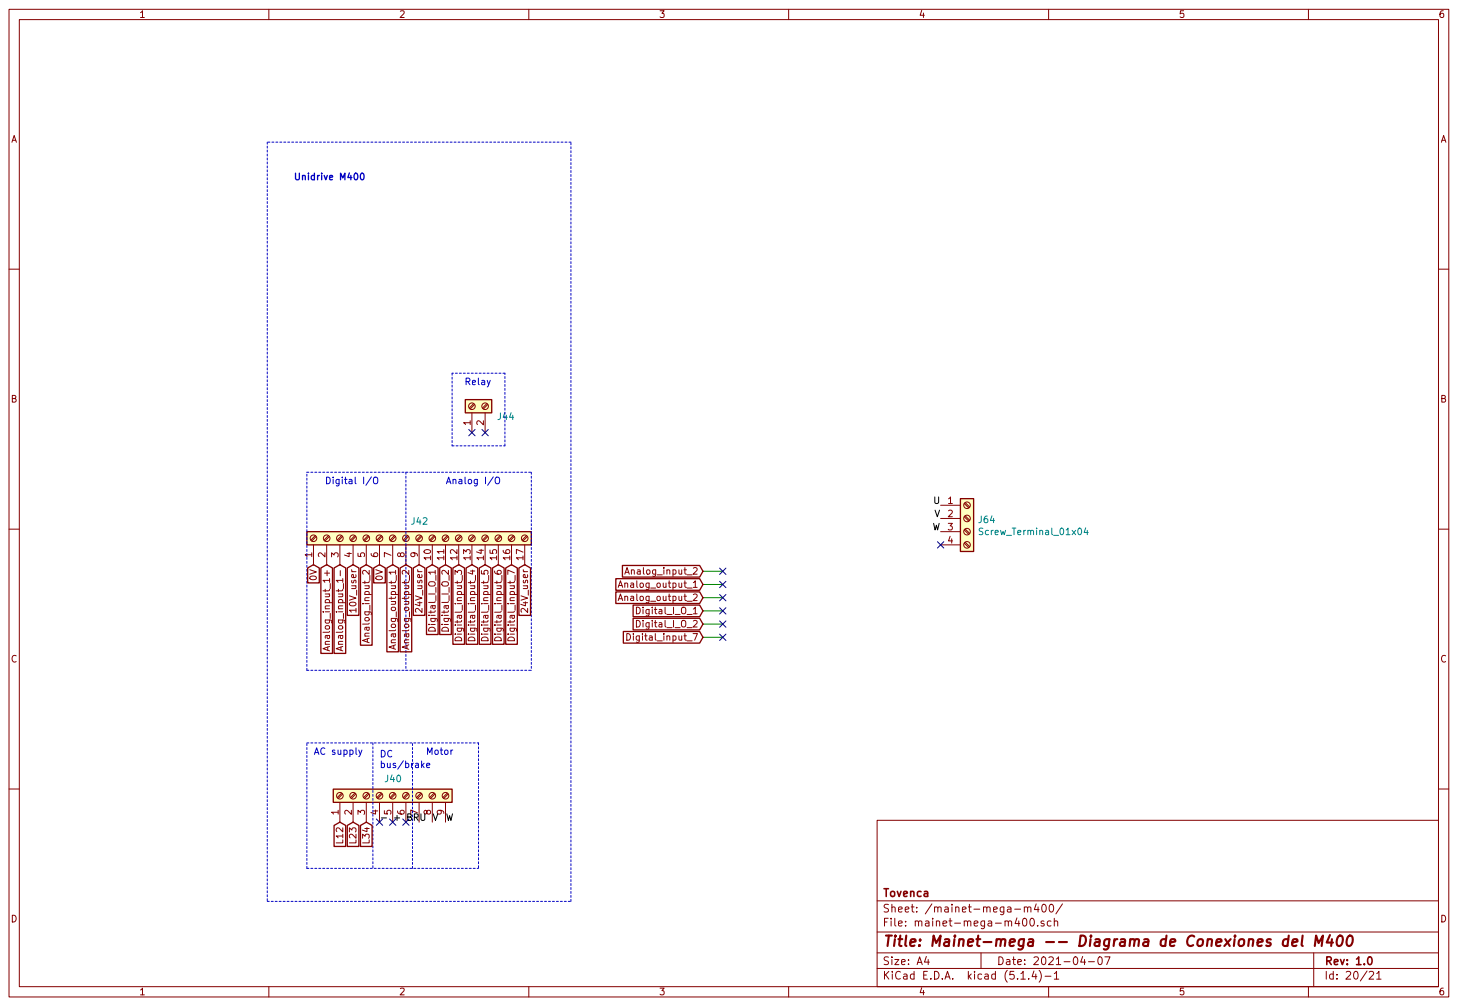
[picture p39: page 20]

Sheet: /mainet-mega-m400/ Tovenca

File: mainet-mega-m400.sch
Id: 20/21 Title: Mainet-mega -- Diagrama de Conexiones del M400


Esta señal es la salida del generafor
de pulsos por rotación trasladada a 5V

Esta señal es la salida del generador
de pulsos por rotación a 24VDC

Sheet: /mainet-mega-rotary-pulse/ Tovenca

File: mainet-mega-rotary-pulse.sch
Id: 21/21 Title: Mainet-mega -- Convertidor de Voltaje: 24V a 5V
