nagar2021/mainet-mega/kicad/pdf/new/mainet-mega-rotary-pulse-mainet-mega-rotary-pulse.pdf

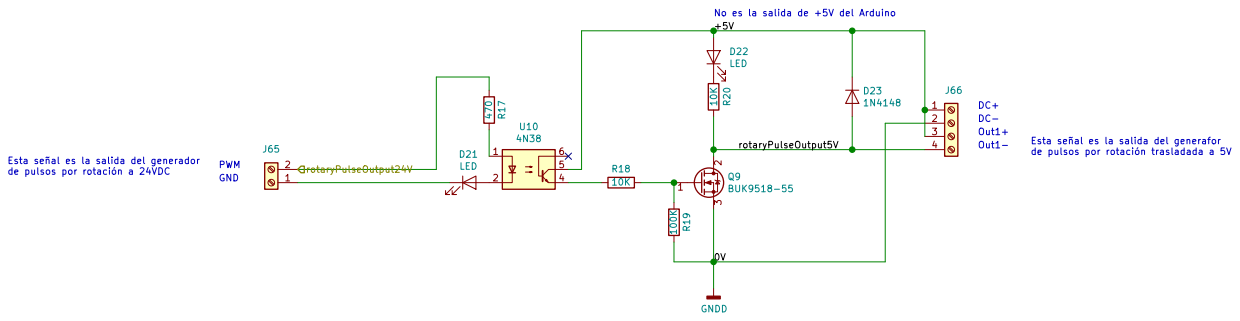
[picture p40: page 1]

No es la salida de +5V del Arduino PWM

Out1- Out1+ DC+ Esta señal es la salida del generador

Esta señal es la salida del generafor
de pulsos por rotación trasladada a 5V

de pulsos por rotación a 24VDC

Sheet: /mainet-mega-rotary-pulse/ Tovenca

File: mainet-mega-rotary-pulse.sch
Id: 21/22 Title: Mainet-mega -- Convertidor de Voltaje: 24V a 5V
