nagar2021/mainet-mega/kicad/pdf/yynmos-4.pdf

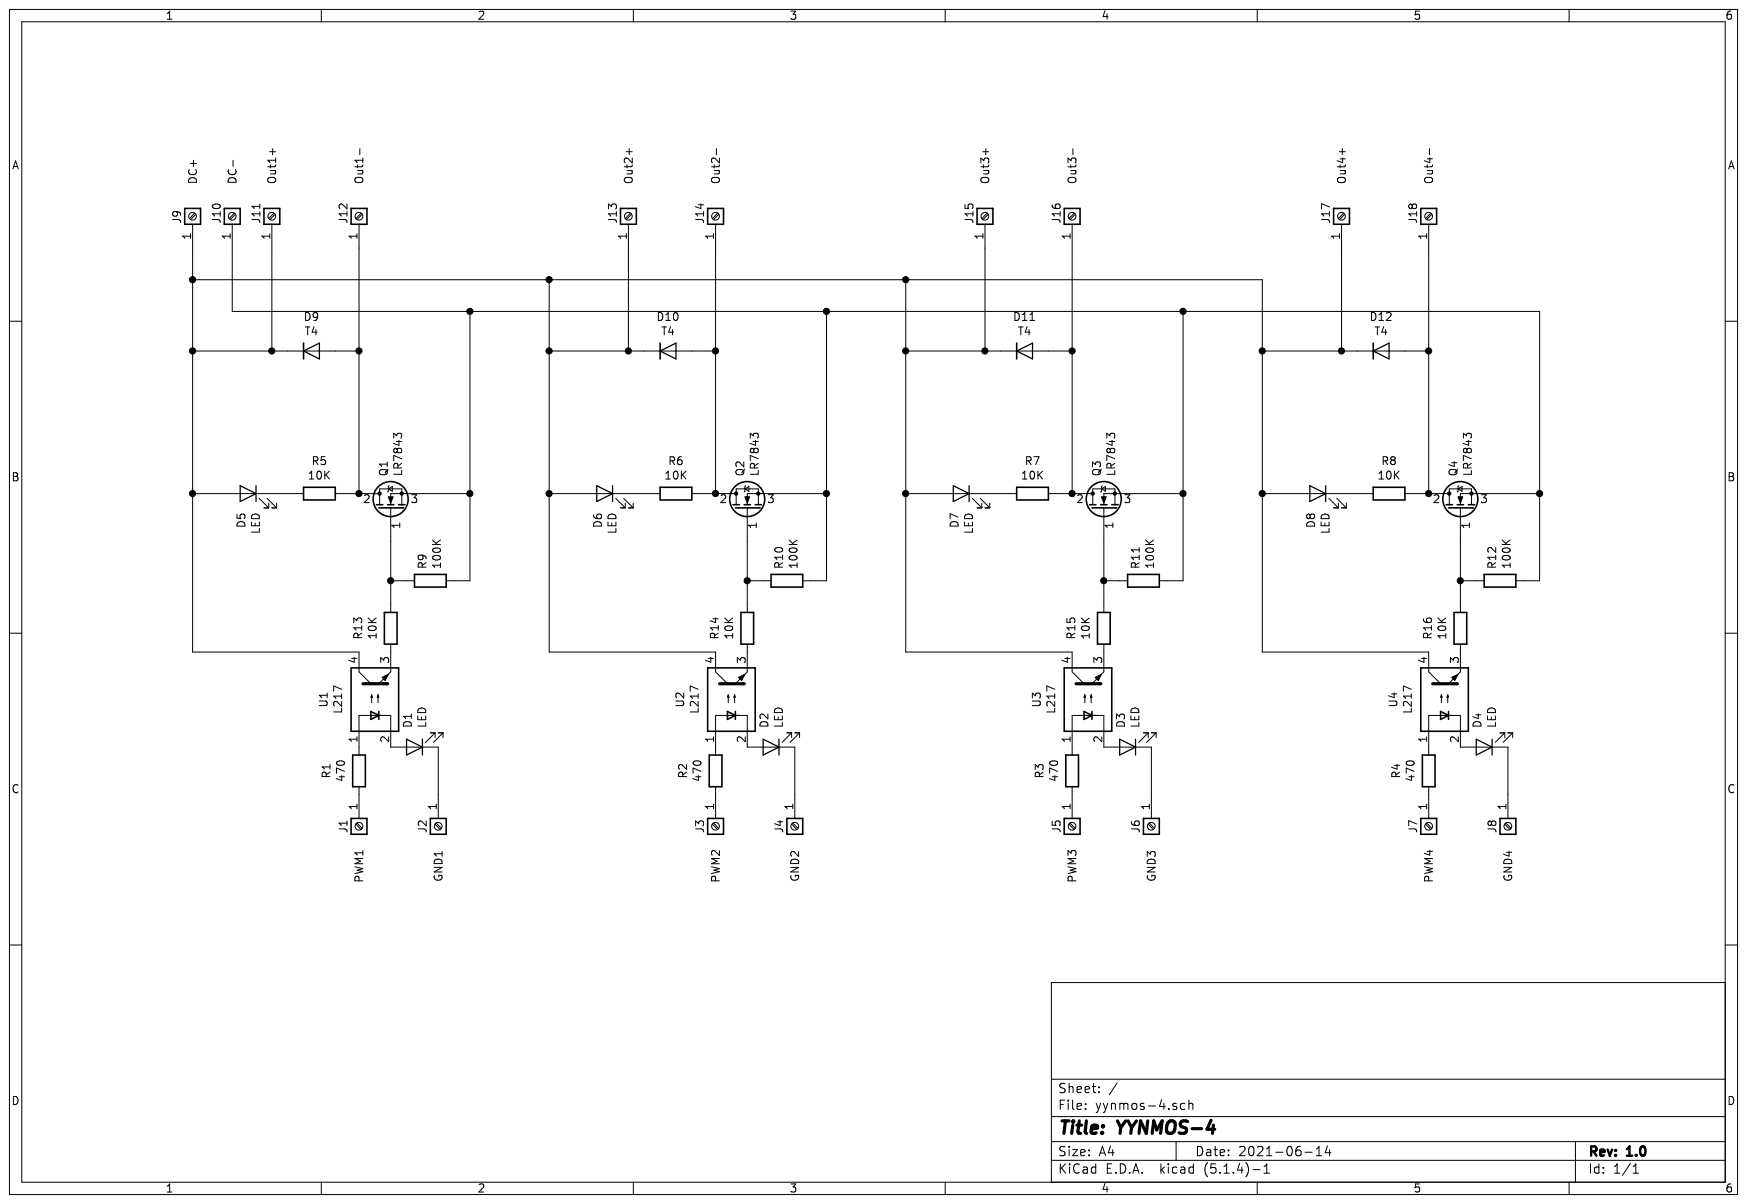
[picture p41: page 1]
