nagar2021/mainet-mega/kicad/pdf/mainet-mega-5V-to-mp-10v-B_Cu.pdf

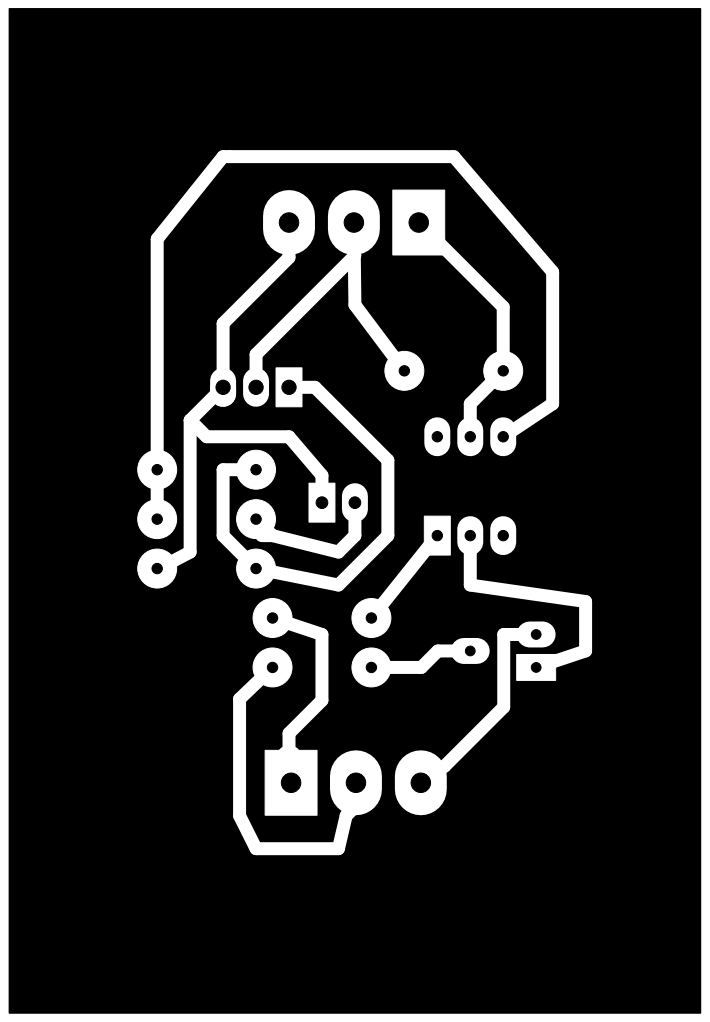
[picture p42: page 1]
