nagar2021/mainet-mega/kicad/pdf/mainet-mega-5v-to-mp-10v.pdf

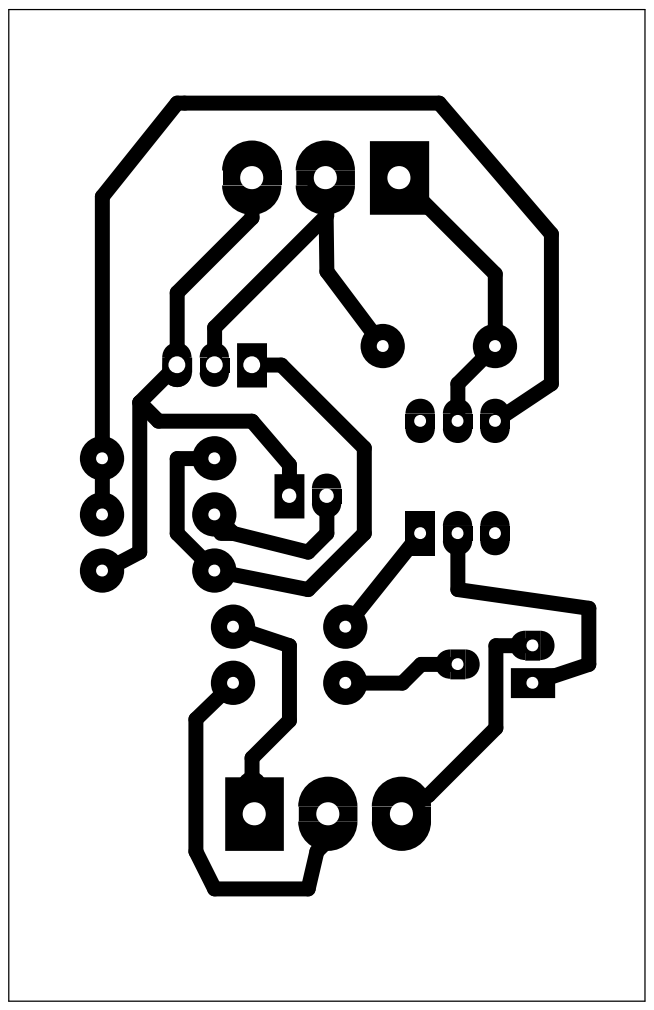
[picture p43: page 1]
