nagar2021/mainet-mega/kicad/pdf/pdf-b-cu/mainet-mega-5V-to-mp-10V--b-cu.pdf

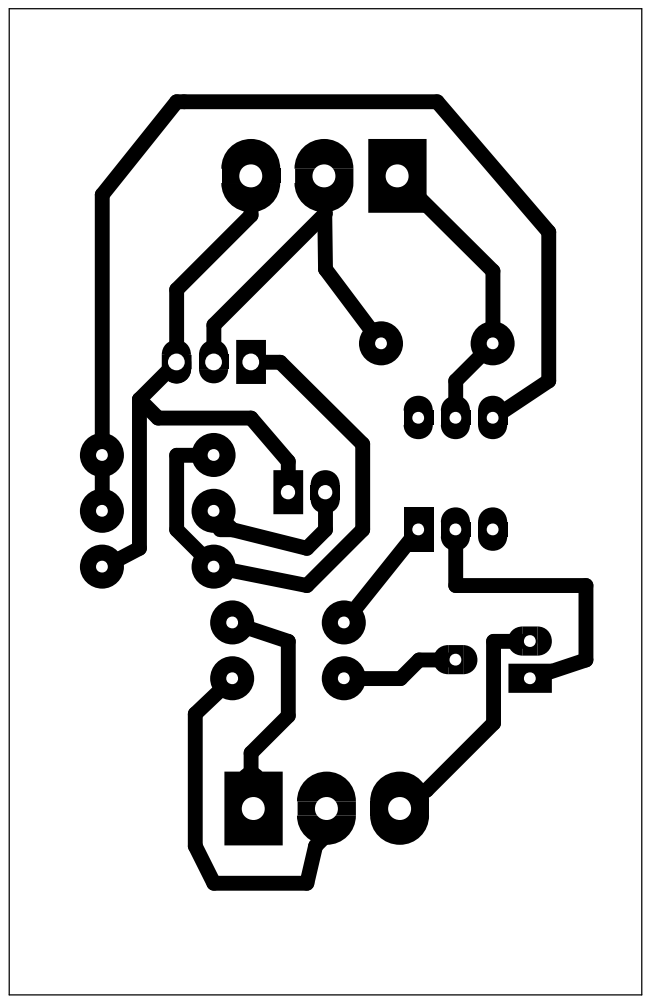
[picture p44: page 1]
