nagar2021/mainet-mega/kicad/mainet-mega-5V-to-mp-10v.kicad_pcb

## KiCad design kicad/mainet-mega-5V-to-mp-10v.kicad_pcb (2023-06-02)

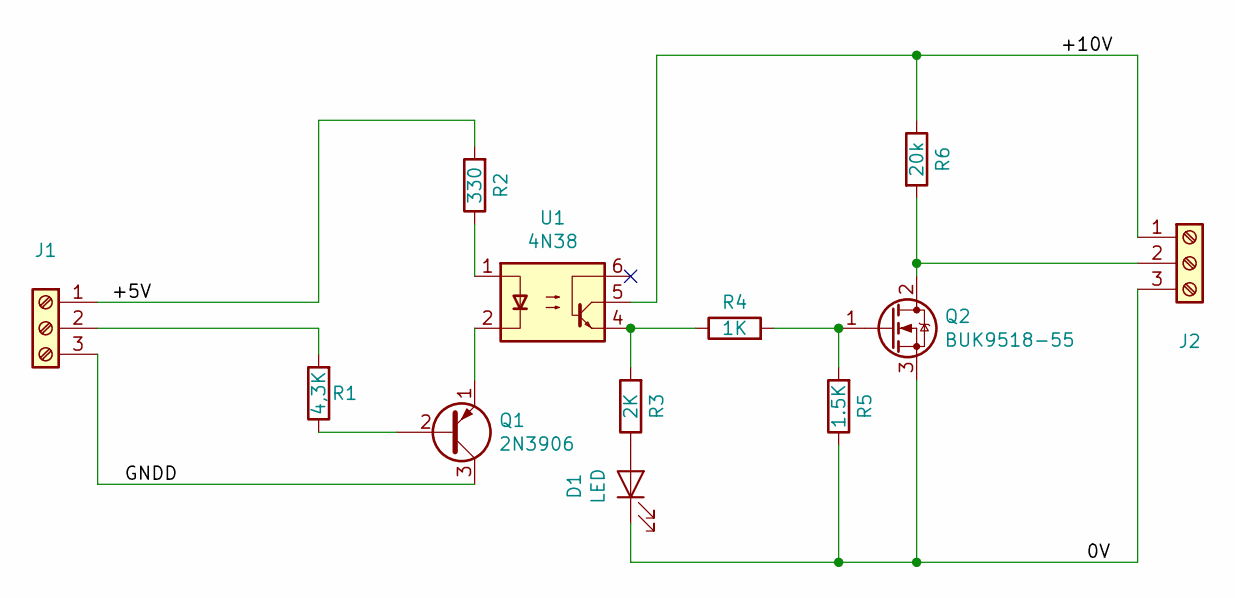
[picture p45: schematic mainet-mega-5v-to-mp-10v.sch, Convertidor de voltaje - Mainet-mega-5 V a MP-10V]

Parts:
D1: LED; LED_D5.0mm
J1, J2: Screw_Terminal_01x03; Altech_AK300_1x03_P5.00mm_45-Degree
Q1: 2N3906; TO-92_Inline
Q2: BUK9518-55; TO-220-3_Vertical
R1: 4,3K; R_Axial_DIN0207_L6.3mm_D2.5mm_P7.62mm_Horizontal
R2: 330; R_Axial_DIN0207_L6.3mm_D2.5mm_P7.62mm_Horizontal
R3: 2K; R_Axial_DIN0207_L6.3mm_D2.5mm_P7.62mm_Horizontal
R4: 1K; R_Axial_DIN0207_L6.3mm_D2.5mm_P7.62mm_Horizontal
R5: 1.5K; R_Axial_DIN0207_L6.3mm_D2.5mm_P7.62mm_Horizontal
R6: 20k; R_Axial_DIN0207_L6.3mm_D2.5mm_P7.62mm_Horizontal
U1: 4N38; DIP-6_W7.62mm

Connections:
/0V: D1.1 (K), J2.3, Q2.3 (S), R5.1
/+5V: J1.1, R2.2
/+10V: J2.1, R6.1, U1.5
/GNDD: J1.3, Q1.3 (C)
unnamed: D1.2 (A), R3.1
unnamed: J1.2, R1.2
unnamed: J2.2, Q2.2 (D), R6.2
unnamed: Q1.1 (E), U1.2
unnamed: Q1.2 (B), R1.1
unnamed: Q2.1 (G), R4.2, R5.2
unnamed: R2.1, U1.1
unnamed: R3.2, R4.1, U1.4

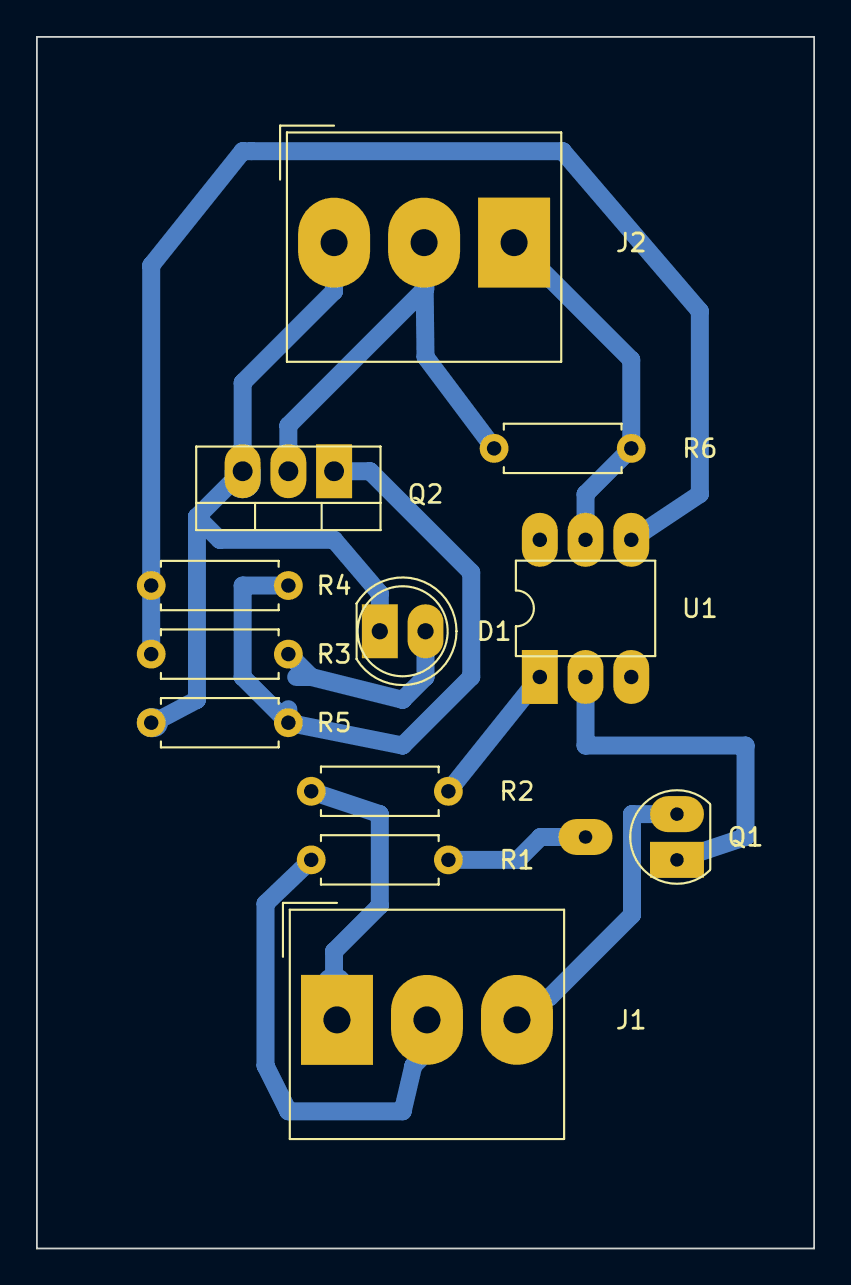
[picture p46: board mainet-mega-5V-to-mp-10v.kicad_pcb from above]

Board: 2 copper layers, 43.2 x 67.3 mm, 12 parts (0 on the bottom side), 12 nets.
