nagar2021/mainet-mega/kicad/mainet-mega-rotary-pulse.kicad_pcb

## KiCad design kicad/mainet-mega-rotary-pulse.kicad_pcb (2023-05-10)

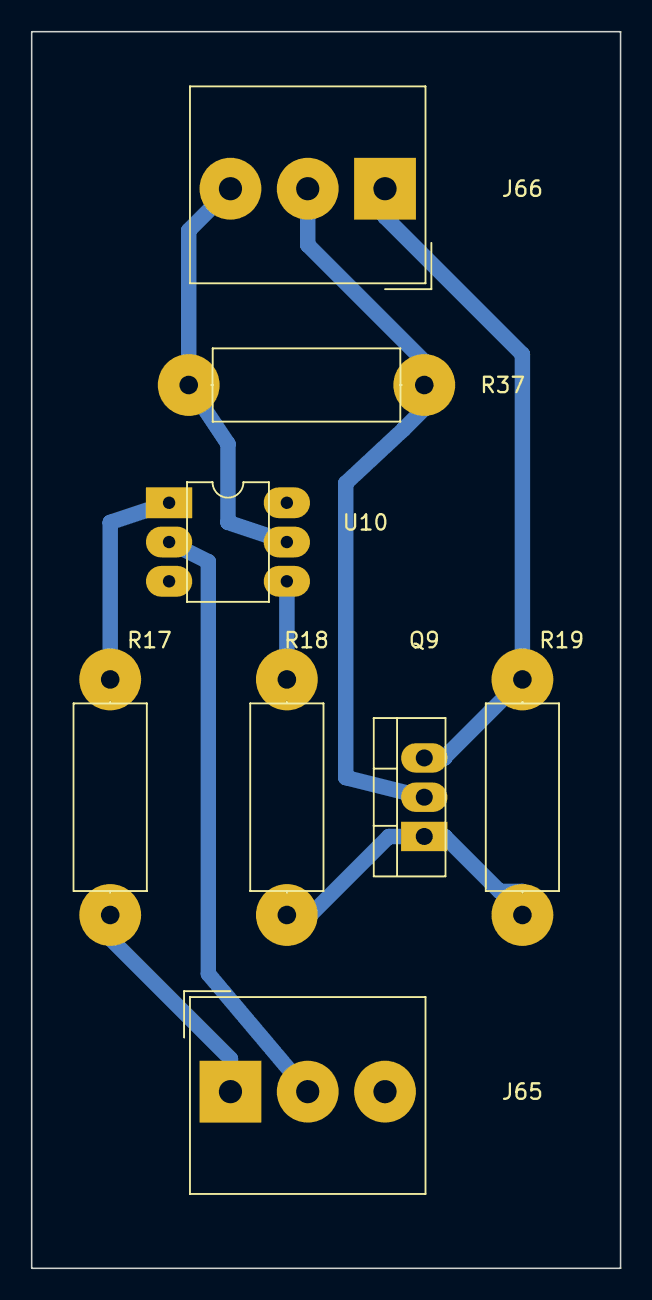
[picture p47: board mainet-mega-rotary-pulse.kicad_pcb from above]

Board: 2 copper layers, 38.1 x 80.0 mm, 8 parts (0 on the bottom side), 8 nets.

Parts:
J65, J66: Screw_Terminal_01x03; Altech_AK300_1x03_P5.00mm_45-Degree
Q9: BUK9518-55; TO-220-3_Vertical
R17: 2.2K; R_Axial_DIN0414_L11.9mm_D4.5mm_P15.24mm_Horizontal
R18: 1K; R_Axial_DIN0414_L11.9mm_D4.5mm_P15.24mm_Horizontal
R19: 6.8K; R_Axial_DIN0414_L11.9mm_D4.5mm_P15.24mm_Horizontal
R37: 20k; R_Axial_DIN0414_L11.9mm_D4.5mm_P15.24mm_Horizontal
U10: 4N38; DIP-6_W7.62mm

Connections:
/+5V: J66.3, R37.1, U10.5
/+24V: J65.1, R17.2
/rotaryPulseOut-24V: J65.2, U10.2
/rotaryPulseOutput: J66.2, Q9.2, R37.2
GNDD: J66.1, Q9.3, R19.1
unnamed: Q9.1, R18.2, R19.2
unnamed: R17.1, U10.1
unnamed: R18.1, U10.4
