nagar2021/mainet-mega/(commit log)

2021-01-26 Eliminación de comentarios innecesarios
2021-01-27 Kicad: Modificaciones menores esquemáticos
    [mainet-mega-botones.sch, mainet-mega-control-relay.sch, mainet-mega-display.sch, mainet-mega-emergencyStopRelay.sch, mainet-mega-m400.sch, mainet-mega-pwm.sch, mainet-mega-relay-driver-1.sch, mainet-mega-relay-driver-2.sch]
2021-01-27 Arduino: Modificación de pines de entrada y salida
    Se agregaron las entradas clutchChuck y brakeChuck
    y sus correspondientes salidas de 24VDC para controlar
    los mandriles neumáticos.
2021-01-27 Kicad: Eliminados _autosave
2021-01-29 Se agregó .gitignore al direcctorio kicad
2021-01-29 Actualización de .gitignore en el directorio raíz
2021-01-29 Correción en definición de pines de salida
2021-01-29 Actualización de kicad/.gitignore
2021-01-29 Cambio de nombre de la etiqueta breakChuck a brakeChuck y correción del pin
    [mainet-mega-control-relay.sch, mainet-mega.sch]
2021-02-01 KiCAD: Se agregó el esquemático del circuito de traslación de voltaje del generador de pulsos de rotación
    [mainet-mega-botones.sch, mainet-mega-control-relay.sch, mainet-mega-display.sch, mainet-mega-emergencyStopRelay.sch, mainet-mega-m400.sch, mainet-mega-potenciómetros.sch, mainet-mega-pwm.sch, mainet-mega-relay-3.sch]
2021-02-01 KiCAD: Se agregó esquemáticos del módulo de coversión de voltaje de 5V a !0 V
    [brakeUnwindControl.sch, frecuencyRefControl.sch, lowerClutchControl.sch, mainet-mega-botones.sch, mainet-mega-control-relay.sch, mainet-mega-display.sch, mainet-mega-emergencyStopRelay.sch, mainet-mega-m400.sch]
2021-02-02 ARDUINO: Eliminación de comentarios innecesarios
2021-02-02 KICAD: Se agregó .gitignore al direcctorio kicad
2021-02-02 GLOBAL: Actualización de .gitignore en la raíz
2021-02-02 ARDUINO: Correción en def. de pines de salida
2021-02-02 KICAD: Actualización de kicad/.gitignore
2021-02-02 KICAD: Cambio etiqueta breakChuck a brakeChuck y correción del pin
    [mainet-mega-control-relay.sch, mainet-mega.sch]
2021-02-02 KiCAD: Se agregó título al esquemático del M400
    [brakeUnwindControl.sch, frecuencyRefControl.sch, lowerClutchControl.sch, mainet-mega-botones.sch, mainet-mega-control-relay.sch, mainet-mega-display.sch, mainet-mega-emergencyStopRelay.sch, mainet-mega-m400.sch]
2021-02-02 KICAD: Actualización de esquematicos del módulo de 8 relés de control
    [brakeUnwindControl.sch, frecuencyRefControl.sch, lowerClutchControl.sch, mainet-mega-botones.sch, mainet-mega-control-relay.sch, mainet-mega-display.sch, mainet-mega-emergencyStopRelay.sch, mainet-mega-m400.sch]
2021-02-02 Documentación pdf del módulo de relés
2021-03-08 Uso de un solo archivo .gitignore
2021-03-11 KICAD: Modificar brakeUnwindControl.sch
    [brakeUnwindControl.sch]
2021-03-11 KICAD: Modificar frecuencyRefControl.sch
    [frecuencyRefControl.sch]
2021-03-11 KICAD: Modificar lowerClutchControl.sch
    [lowerClutchControl.sch]
2021-03-11 KICAD: Modificar upperClutchControl.sch
    [upperClutchControl.sch]
2021-03-11 KICAD: Modificar mainet-mega-rotary-pulse.sch
    [mainet-mega-rotary-pulse.sch]
2021-03-11 ARDUINO: Actualizar mainet-mega/mainet-mega.ino
2021-03-11 KICAD: Agregar PCB de mainet-mega-rotary-pulse
    [mainet-mega-rotary-pulse.kicad_pcb]
2021-03-11 KICAD: Agregar mainet-mega-rotary-pulse-cache.lib
2021-03-13 Modificar .gitignore Incluir archivos de .vscode/ y otros de KiCAD
2021-03-13 KICAD: Corregir mainet-mega-rotary-pulse.kicad_pcb
    [mainet-mega-rotary-pulse.kicad_pcb]
2021-03-16 KICAD: Agregar esquemaático... mainet-mega-emergencyControlRelay.sch
    [mainet-mega-emergencyStopRelay.sch]
2021-03-16 KICAD: Agregar cache de lib... mainet-mega-cache.lib
2021-03-16 KICAD: Actualizar esquemático... mainet-mega-ritary-pulse
    [mainet-mega-rotary-pulse.sch]
2021-03-16 .gitignore fix
    [brakeUnwindControl.sch, frecuencyRefControl.sch, lowerClutchControl.sch, mainet-mega-botones.sch, mainet-mega-control-relay.sch, mainet-mega-dac-mosfet.sch, mainet-mega-display.sch, mainet-mega-emergencyStopRelay.sch]
2021-03-22 Agregar documentación sobre diseño de PCB
2021-03-23 KICAD: Agregar pdf del PCB mainet-mega-5v-to-mp-10v (negativo)
2021-03-24 KICAD: Corregir error en .gitignore No deben ignorarse los archivos *-rescue.lib
2021-03-24 KICAD: Agregar libreria de rescate: mainet-mega-rescue-lib
2021-03-24 KICAD: Corregir .gitignore Importante rastrear archivos *-rescue.lib
2021-03-24 KICAD: Corregir .gitignore
2021-03-24 KICAD: Eliminar kicad/.gitignore
2021-03-24 KICAD: Agregar archivos .lib
2021-03-24 KICAD: Agreagar sch de emergencyStopRelay
    [mainet-mega-emergencyStopRelay.sch]
2021-03-24 KICAD: Actualizar esquemático mainet-mega-emergencyStopRelay
    [mainet-mega-emergencyStopRelay.sch]
2021-03-25 KICAD: Fix .gitignore
2021-03-25 KICAD: Actualizar sch Fecha y versión
    [brakeUnwindControl.sch, frecuencyRefControl.sch, lowerClutchControl.sch, mainet-mega-botones.sch, mainet-mega-control-relay.sch, mainet-mega-display.sch, mainet-mega-emergencyStopRelay.sch, mainet-mega-m400.sch]
2021-04-06 KICAD: Corregir libreria de rescate
2021-04-06 Corregir .gitignore para excluir archivos de sincronización de SyncToy
2021-04-07 KICAD: Actualizar fecha
    [brakeUnwindControl.sch, frecuencyRefControl.sch, lowerClutchControl.sch, mainet-mega-botones.sch, mainet-mega-control-relay.sch, mainet-mega-display.sch, mainet-mega-emergencyStopRelay.sch, mainet-mega-m400.sch]
2021-04-07 KICAD: Actualizar .sch
    [frequencyRefControl.sch]
2021-04-07 KICAD: Actualizar esquemáticos
    [brakeUnwindControl.sch, frecuencyRefControl.sch, lowerClutchControl.sch, mainet-mega-botones.sch, mainet-mega-control-relay.sch, mainet-mega-display.sch, mainet-mega-emergencyStopRelay.sch, mainet-mega-m400.sch]
2021-04-07 KICAD: Actualizar mainet-mega.pro
2021-04-07 Borrar pdf (PCB)
2021-04-07 KICAD: Incluir pdf de arcivos sch
2021-05-12 KICAD: Agregar bordes de corte mainet-mega-rotary-pulse.kicad_pcb
    [mainet-mega-rotary-pulse.kicad_pcb]
2021-05-12 KICAD: Agregar plano de tierra mainet-mega-rotary-pulse.kicad_pcb
    [mainet-mega-rotary-pulse.kicad_pcb]
2021-06-14 KICAD: Agregar data sheet: L217 LR7843
2021-06-14 KICAD: Agregar esquemático del módulo YYNMOS-4
    [yynmos-4.kicad_pcb, yynmos-4.sch]
2021-06-15 KICAD: Agregar correcciones esquemáticos yynmos-4
2021-06-16 KICAD: Modificar mainet-mega-relay-driver-1.sch
    [mainet-mega-relay-driver-1.sch]
2021-06-16 KICAD: Corregir kicad/mainet-mega-m400.sch
    [mainet-mega-m400.sch]
2021-06-16 KICAD: Corregir nombre del pin 34 del M400
    [mainet-mega-relay-driver-1.sch]
2021-06-16 KICAD: Modificar esquemático
    [mainet-mega-relay-driver-2.sch]
2021-06-16 KICAD: Modificar esquemático m400
    [mainet-mega-m400.sch]
2021-06-17 KICAD: Eliminar mainet-mega-relay-3.sch
    [mainet-mega-relay-3.sch]
2021-06-17 KICAD: Agregar nuevo esquemático mainet-mega-regleta-conexiones-motores.sch
    [mainet-mega-regleta-conexiones-motores.sch]
2021-06-17 KICAD: Actualizar archivos del módulo de relés
    [mainet-mega-relay-driver-1.sch, mainet-mega-relay-driver-2.sch, mainet-mega-relay-driver-3.sch, mainet-mega-relay-driver-4.sch, mainet-mega-relay-driver-5.sch, mainet-mega-relay-driver-6.sch, mainet-mega-relay-driver-7.sch, mainet-mega-relay-driver-8.sch]
2021-06-17 KICAD: Actulizar .sch del M400
    [mainet-mega-m400.sch]
2021-06-17 KICAD: Agregar pdf info del módulo YYNMOS-4
2021-06-18 KICAD: Agregar cambios esquemáticos
    [frequencyRefControl.sch, mainet-mega-relay-driver-1.sch, mainet-mega-relay-driver-2.sch, mainet-mega-relay-driver-3.sch, mainet-mega-relay-driver-4.sch, mainet-mega-relay-driver-5.sch, mainet-mega-relay-driver-6.sch, mainet-mega-relay-driver-7.sch]
2021-06-25 KICAD: Agregar datasheet de 1N4148
2021-06-25 KICAD: Agregar cambios esquemático del generador rotacional de pulsos
    [mainet-mega-rotary-pulse.sch, mainet-mega.sch]
2021-06-25 KICAD: Guardar cambio menor en sch
    [mainet-mega-rotary-pulse.sch]
2021-06-25 KICAD: Guardar cambios sch del control de frecuencia M400
    [frequencyRefControl.sch, mainet-mega.sch]
2021-06-25 KICAD: Agregar archivos pdf de sch nuevos
2021-06-25 KICAD: Actualizar archivo sch del proyecto
2021-06-28 KICAD: Modificar sch del RPG
    [mainet-mega-rotary-pulse.sch, mainet-mega.sch]
2021-06-29 KICAD: Incluir power jack en el .sch
    [mainet-mega.sch]
2021-06-29 KICAD: Actualizar archivos sch
    [mainet-mega-emergencyStopRelay.sch, mainet-mega-rotary-pulse.sch, mainet-mega.sch]
2021-06-29 KICAD: Actualizar archivo .lib
2021-07-01 KICAD: Agregar nuevo símbolo : +5V_Nextion
2021-07-01 KICAD: Actualizar el cache de las librerías
2021-07-01 KICAD: Actualizar .sch del display Nextion
    [mainet-mega-display.sch, mainet-mega.sch]
2021-07-02 KICAD: Corregir pines de salida digital del Arduino para control de relés y pines de cableado con la pantalla Nextion
    [mainet-mega-display.sch, mainet-mega.sch]
2021-07-02 ARDUINO: Corregir pines de salida digital para control de relés
2021-07-02 ARDUINO: Agregar correcciones programación Arduino
2021-07-02 KICAD: Agregar correciones sch
    [mainet-mega-display.sch, mainet-mega.sch]
2021-07-02 KICAD: Corregir pinout conector RPG
    [mainet-mega-rotary-pulse.sch]
2021-07-02 KICAD: Actualizar archivo cache .lib
2021-07-06 KICAD: Agregar correcciones en .sch
    [mainet-mega-rotary-pulse.sch]
2021-07-06 KICAD: Agegar cambios en .sch de mainet-mega-rotary-pulse.sch
    [mainet-mega-rotary-pulse.sch]
2021-07-06 KICAD: AGregar cambios en .sch del controlador de frecuencia
    [frequencyRefControl.sch]
2021-07-07 KICAD: Agregar cambios a .sch
    [frequencyRefControl.sch]
2021-07-09 KICAD: Modificar sch del M400
    [mainet-mega-m400.sch]
2021-07-09 KICAD: Guardar cambios sch de los controles de los cluches y freno
    [brakeUnwindControl.sch, lowerClutchControl.sch, mainet-mega.sch, upperClutchControl.sch]
2021-07-13 KICAD: Guardar cambios en sch RPG
    [mainet-mega-rotary-pulse.sch]
2021-07-13 KICAD: Guardar cambios .sch frequencyRefControl
    [frequencyRefControl.sch]
2021-07-13 KICAD: Agregar cvambios .sch controles tarjetas MP
    [brakeUnwindControl.sch, lowerClutchControl.sch, upperClutchControl.sch]
2021-07-13 IMAGES: Cambiar yynmos-4.jpg de carpeta
2021-07-14 KICAD: Actualiar el cache de la librería
2021-07-14 KICAD: Actualizar .sch regleta de conexiones
    [mainet-mega-emergencyStopRelay.sch]
2021-07-14 KICAD: Actualizar .sch regleta conexión embragues
    [mainet-mega-regleta-conexiones-motores.sch]
2021-07-14 KICAD: Actualizar .sch chuck embrague inferior
    [mainet-mega-relay-driver-6.sch]
2021-07-14 KICAD: Actualizar .sch chunk del freno
    [mainet-mega-relay-driver-7.sch]
2021-07-14 KICAD: Actualizar .sch del proyecto
    [mainet-mega.sch]
2021-07-15 KICAD: Actualizar sch de la regleta de conexiones
    [mainet-mega-regleta-conexiones-motores.sch]
2021-07-15 KICAD: Actualizar sch del pulsador de emergencia
    [mainet-mega-emergencyStopRelay.sch]
2021-07-15 KICAD: Actualizar sch del diagrama a bloques
    [mainet-mega.sch]
2021-07-15 KICAD: Actualizar el cache de librerías
2021-07-16 KICAD: Actualizar .sch del relé de parada de emergencia
    [mainet-mega-emergencyStopRelay.sch]
2021-07-16 KICAD: Actualizar .sch de la regleta de conexiones de embragues y freno
    [mainet-mega-regleta-conexiones-motores.sch]
2021-07-16 : Actualizar .sch diagrama de bloques
    [mainet-mega.sch]
2021-07-16 KICAD: Reorganizar .sc regleta de conexiones
    [mainet-mega-regleta-conexiones-motores.sch]
2021-07-16 KICAD: Reorganizar .sch relé de parada
    [mainet-mega-emergencyStopRelay.sch]
2021-07-20 KICAD: Actualizar fech *.sch antes de las primeras pruebas de MAINET
    [brakeUnwindControl.sch, frequencyRefControl.sch, lowerClutchControl.sch, mainet-mega-botones.sch, mainet-mega-control-relay.sch, mainet-mega-display.sch, mainet-mega-emergencyStopRelay.sch, mainet-mega-m400.sch]
2021-07-20 KICAD: Agregar conexiones de la Guía de banda regleta de conexiones
    [mainet-mega-regleta-conexiones-motores.sch]
2021-07-20 KICAD: Actualizar .sch regleta de conexiones Agrega conexión para la guía de banda
    [mainet-mega-regleta-conexiones-motores.sch]
2021-07-20 KICAD: Actualizar .sch manejadores de relés Agrega alimentación de +5V de dispositivos del lado del Arduino diferente a la salida de +5V del Arduino
    [mainet-mega-relay-driver-1.sch, mainet-mega-relay-driver-2.sch, mainet-mega-relay-driver-3.sch, mainet-mega-relay-driver-4.sch, mainet-mega-relay-driver-5.sch, mainet-mega-relay-driver-6.sch, mainet-mega-relay-driver-7.sch]
2021-07-20 KICAD: Actualizar .sch general del proyecto
    [mainet-mega.sch]
2021-07-20 PDF: Agregar hoja de datos de la pantalla Nextion NX8048P070-011C-Y
2021-07-21 PDF: Agrtegar hoja de datos ATmega
2021-07-21 KICAD: Corregir numeración pines Arduino de control de relés
    [mainet-mega-control-relay.sch, mainet-mega-relay-driver-1.sch, mainet-mega-relay-driver-2.sch, mainet-mega-relay-driver-3.sch, mainet-mega-relay-driver-4.sch, mainet-mega-relay-driver-5.sch, mainet-mega-relay-driver-6.sch, mainet-mega-relay-driver-7.sch]
2021-07-21 ARDUINO: Actualizar programa correcciones generales
2021-07-29 PDF: Incluir info de las valvulas solenoides 5 puertos 2 posiciones simple VFS2120-5D-02N
2021-07-29 KICAD: Actualizar pines de control en .sch de embragues y freno
    [brakeUnwindControl.sch, frequencyRefControl.sch, lowerClutchControl.sch, upperClutchControl.sch]
2021-07-29 ARDUINO: Actualizar programa
2021-07-30 KICAD: Correguir frequencyRefControl.sch conexión erronea en J72
    [frequencyRefControl.sch]
2021-07-30 KICAD: Agregar User_enable_1 al .sch del M400. Así se puede inhibir su funcionamiento desde el SW machineEnable (User_machine_2) y desde el software Ambas señales deben ser HIGH para permitir el func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
    [mainet-mega-m400.sch]
2021-07-30 KICAD: Agregar .sch para usar el relé 8 para inhibir el M400 desde el software
    [mainet-mega-relay-driver-8.sch]
2021-07-30 VSCODE: Actualizar settings del espaciop de trabajo
2021-08-02 ARDUINO: Agregar habilitación de conteo
2021-08-04 ARDUINO: Modificar habilitación del conteo para usar interrupción en el conteo de pulsos
2021-08-05 ARDUINO: Modificar ISR del contador de pulsos
2021-08-06 KICAD: Actualizar pin de entrada del Arduino-mega que recibe la señal del generador rotacional de pulsos
    [mainet-mega-rotary-pulse.sch]
2021-08-06 ARDUINO: Actualizar tipo de variable numeroDePulsos a long
2021-08-08 NEXTION: Actualizar HMI, nueva apariencia Se agrega un botón para reiniciar el conteo de etiquetas
2021-08-08 ARDUINO: Agregar función para reiniciar el contador de etiquetas
2021-08-09 KICAD: Agregar imagenes del RPG al .sch
    [mainet-mega-rotary-pulse.sch]
2021-08-10 KICAD: Actualizar .sch del acondicionador de los pulsos del RPG de 24V a 5V
    [mainet-mega-rotary-pulse.sch]
2021-08-10 ARDUINO: Actualizar program Arduino
2021-08-12 ARDUINO: Agregar visualización del reinicio de conteo en la funcción trigger3()
2021-08-12 KICAD: Borrar mainet-rotary-pulse.pro
2021-08-12 KICAD: Cambiar .sch de frequencyRefControl se volvió al diseño original del PWM
    [frequencyRefControl.sch]
2021-08-16 KICAD: Agregar valores resistencias
    [frequencyRefControl.sch]
2021-08-16 KICAD: Actualizar .sch general
    [mainet-mega.sch]
2021-08-17 ARDUINO: Actualizar .ino
2021-08-18 NEXTION: Establecer comunicación a 115200 y otros cambios en la programación. Se agrega entrada a la página 1 al tocar la caja del número de etiquetas por rollo, o la de número de etiquetas contadas.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
2021-08-18 ARDUINO: Establecer Serial2 a 115200 y otros: Agregar constantes para los colores usados en la pantalla Nextion y que son modificados desde el Arduino-mega. Se reordena las funciones triggerx()
2021-08-20 ARDUINO: Cambiar unsigned int por uint32_t
2021-08-20 ARDUINO: Corregir error de representación Se asignó o512 y no 0512 en una variable y el compilador lo tomaba como un octal
    [mainet-mega.ino]
2021-08-20 ARDUINO: Agregar funciones trigger3...6
2021-08-24 ARDUINO: Cambiar valores iniciales en Nextion
2021-08-25 ARDUINO: Agregar función de diagnóstico
2021-08-26 ARDUINO: Cambiar uint32_t por unsigned long
2021-08-26 NEXTION: Cambiar a global las variables asociadas a los indicadores de freno, velocidad, y embragues
2021-08-26 ARDUINO: Definir como uint32_t todas las variables asociadas a propiedades numéricas de componentes Nextion
2021-08-27 ARDUINO: Actualizar funciones de lectura de los potenciómetros de control de frenado, embragues y velocidad, para hacer la visualización menos brusca. El valor no se actualiza si la diferencia con la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
2021-08-27 ARDUINO: Agregar función de frenado auto
2021-08-31 ARDUINO: Agregar código correspondiente al nuevo diseño de pantalla
2021-08-31 ARDUINO: Agregar función de parada
2021-09-01 ARDUINO: Agregar funciones nuevas
2021-09-06 ARDUINO: Correcciones en frenado
2021-09-07 ARDUINO: Cambiar etiquetaDeFrenadoNum a uint32_t
2021-09-07 ARDUINO: Cambiar no. función trigguer
2021-09-08 ARDUINO/NEXTION: Cambiar lógica frenado
2021-09-08 ARDUINO: Agregar reinicio del conteo de etiquetas al desconectar el mandril del embrague
2021-09-09 ARDUINO: Cambiar dutyCycleMin a 15%
2021-09-09 NEXTION: Agregar caja para visualización... de la velocidad del material en m/min
2021-09-09 ARDUINO: Agregar calcularFrecuencia()
2021-09-10 NEXTION: Modificar cálculo etiqueta de frenado al 90% del número de etiquetas por rollo
2021-09-16 ARDUINO: Agregar cálculo velocidad m/min
2021-09-16 ARDUINO: Corregir error factor de conversión de unidades
    [mainet-mega.ino]
2021-09-21 ARDUINO: Agregar variables lógicas para depuración
2021-09-22 ARDUINO: Modificar calcularVelocidad
2021-09-23 ARDUINO: Unificar puerto a COM4 en todos los PC uisados
2021-09-23 ARDUINO: Eliminar espacios en blanco al final de línea
2021-09-24 KICAD: Actualizar librerias cache y rescue
2021-09-24 KICAD: Actualizar .sch para agregar cambio de giro
    [mainet-mega-botones.sch, mainet-mega-control-relay.sch, mainet-mega-display.sch, mainet-mega-relay-driver-8.sch, mainet-mega.sch]
2021-09-24 ARDUINO: Agregar función de cambio de giro
2021-09-29 ARDUINO: Agregar función checkStartRun Se agrega un SW para marcha hacia adelante y reversa
    [mainet-mega.ino]
2021-09-29 ARDUINO: Modificar preferencias arduino
2021-09-29 ARDUINO: Agregar las fns: checkRunReverse() y checkRunOff() y modificar checkRunForward() para implementar el cambio de giro
2021-09-30 ARDUINO: Modificar checkStopRun() para que desconecte el relé de marcha inversa
2021-09-30 ARDUINO: Borrar algunos comentarios innecesarios
2021-09-30 ARDUINO: Modificar ciclo de trabajo mínimo al 15%
2021-10-01 ARDUINO: Modificar funciones de verificación de estado de los mandriles de los embragues y del freno
2021-10-01 NEXTION: Modificar campos FRENO y EMBRAGUES a global para modificar color desde el Arduino
2021-10-04 NEXTION: Agregar imagenes nuevas indicadores velocidad, freno y embragues
2021-10-05 NEXTION: Agregar opciones para el cálculo por defecto de la etiqueta de frenado: -5, -10, -15, -20 % del número de etiquetas por rollo
2021-10-05 NEXTION/ARDUINO: Agregar opciones para fijar el ciclo útil mínimo (10, 15,20y 25%)
2021-10-06 NEXTION: Corregir error en calculo 80% etiqueta de frenado
2023-05-10 Agregar capa anterior de serigrafía
    [mainet-mega-rotary-pulse.kicad_pcb]
2023-05-10 Corregir numeración de pines J65
    [mainet-mega-rotary-pulse.sch]
2023-05-10 Agregar archivo de serigrafia anterior
2023-05-10 Actualizar archivo .pro Cambio de pines en J65
2023-05-11 Agregar archivo capa trasera de Cu
2023-05-11 Modificar pcb
    [mainet-mega-5V-to-mp-10v.kicad_pcb]
2023-06-02 Actualizar numeración de pines en terminales J2
    [mainet-mega-5v-to-mp-10v.sch]
2023-06-02 Corregir numeración de pines terminales J2 / PCB
    [mainet-mega-5V-to-mp-10v.kicad_pcb]
2023-06-02 Corregir numeración de pines en J2 tarjetas PWM
    [brakeUnwindControl.sch, frequencyRefControl.sch, lowerClutchControl.sch, mainet-mega-pwm.sch, mainet-mega-rotary-pulse.sch, upperClutchControl.sch]
